rusefi/alphax-8chan/(threads)

Thread 1 (2022-03-19):

Baro LPS22HBTR C94049

rusefillc, 2022-03-19:
can we fit on-board I2C baro LPS22HBTR | C94049

rusefillc, 2022-10-01:
@mck1117 do we have software I2C or do we need hardware I2C?

mck1117, 2022-10-03:
proteus uses bit bang (software) i2c and it works fine enough for baro, so any gpio will work.

rusefillc, 2022-10-20:
@andreika-git please use non-I2C GPIO

andreika-git, 2022-10-23:
Added the baro sensor:

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

Closed 2022-10-23.

Thread 3 (2022-06-28):

analog mux between IAT and CLT, where else?

rusefillc, 2022-06-28:
https://github.com/rusefi/stim is finally a success shall we use same analog mux chip on 8chan for VBatt/CLT/IAT/something else?

actually let's use C91307 2 input/single control bit

IAT/CLT
AT3/AT4
VBAT/xxx?

mck1117, 2022-06-28:
Use the same 2-input muxes as inside the VR-discrete module.

Usable on any channel other than MAP or knock.

rusefillc, 2022-06-28:
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

C87403
NC7SB3157P6X $5 no way

@andreika-git did we substitute on alphax?

mck1117, 2022-06-29:
there are plenty of cheap options like  C91307

https://jlcpcb.com/parts/componentSearch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

rusefillc, 2022-10-01:
#17

ElDominio, 2022-10-01:
I'd say choose some of the last pins in the pinout to be low priority Analog inputs, maybe have the first 10/12 high priority then the rest low priority?

rusefillc, 2022-10-01:
@andreika-git let's mux one of the aux analog inputs with a 3rd single channel mux controller by same AMUX line

rusefillc, 2022-10-03:
@andreika-git let's mux one of aux from #16

andreika-git, 2022-10-05:
Done!
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

rusefillc, 2022-10-05:
@mck1117 :)

mck1117, 2022-10-05:
@andreika-git wait, is that mux BEFORE the analog input filtering stage? That WILL NOT work. It must be muxed as close to the MCU as possible. The analog input filters only have a few hundred hz of bandwidth, so switching between inputs at hundreds of hz will not work.

mck1117, 2022-10-05:
> @mck1117 what's your level of confidence with single control line, multiple 2-input muxes implementation?

100% confident, but the mux does need to be in the correct spot for it to work.

andreika-git, 2022-10-06:
Now mux is between filtered signals closer to mcu:
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

Closed 2022-10-07.

Thread 4 (2022-07-24):

SD card and battery

rusefillc, 2022-07-24:
SD card requirment would mean we are waiting to test a real life https://github.com/rusefi/alphax-4chan/issues/40

rusefillc, 2022-10-01:
4chan rev E has working SD

andreika-git, 2022-10-01:
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

Closed 2022-10-01.

Thread 5 (2022-07-24):

configurable high OR low side aux output, 5A

rusefillc, 2022-07-24:
Can we have a configurable high OR low side 5A output?

rusefillc, 2022-07-30:
would TLE9201 be the best or at least one of the options for high-current configrable push-pull output?

rusefillc, 2022-08-05:
@dron0gus says MC33879 but 0.6A

Qwerty-OFF, 2022-08-05:
MC33887APVW

rusefillc, 2022-08-06:
MC33887APVW looks great!

@dron0gus can you please double-check just to confirm that we can use MC33887APVW as two independent pull/push outputs?

dron0gus, 2022-08-08:
@rusefillc
It is possible to use MC33887APVW as two independent push/pull,
BUT it is not possible to independently switch one output to Hi-Z. Only both at the same time.
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

dron0gus, 2022-08-08:
TLE94112EL is cool. But almost out of stock.

rusefillc, 2022-09-25:
@mck1117 what are your thoughts on MC33887APVW as most flexible push/pull chip?

Closed 2022-10-01.

Thread 6 (2022-07-30):

Physical layout and dimentions

rusefillc, 2022-07-30:
We plan to use our 100% custom CNC case

the only requirent is to have 120 pins of superseal on the same side of the case

Still open question if we will be using 60+60 or 26+34+60 or 60+26+34

great news we have 60 pin footprint already which is 26+34 in single mold of plastic https://github.com/rusefi/kicad6-libraries/commit/ed6bdc60ffba10368ea4b33408f324d4e7dc192b

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

rusefillc, 2022-10-21:
Status update:

J10 stays as 60 pin header like 6437288-3

J11A should be 34 pin 6437288-1
J11B should be 26 pin 6473423-1

Depends on https://github.com/rusefi/kicad6-libraries/issues/1

rusefillc, 2022-11-08:
@andreika-git "J10 stays as 60 pin header like 6437288-3"

i.e. it should be not two (J10+J11) but also not four (J10+J11+J21+J22) but three (60+34+26) if possible

Closed 2022-12-11.

Thread 7 (2022-07-30):

On-board MAP

rusefillc, 2022-07-30:
@eldominio if we fancy a fancy CNC metal case do you see 8chan having on-board MAP sensor or not really?

ElDominio, 2022-07-30:
Yes please, most people need it since they don't know how to connect cables.

rusefillc, 2022-07-30:
"Hex Bulkhead Straight Fitting 2PCS Hose Barb Bulkhead Hex Union Brass Barbed Fitting Connector with 1/4inch Flat Washers"

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

rusefillc, 2022-07-30:
@ElDominio where do you want to place the nipple? would you like the nipple between 60 and 60 or else?

rusefillc, 2022-07-30:
@ElDominio what sensor do you prefer?

there is MPX5700AP which seems to be more suited for brass fitting and hose without turns inside the ECU

rusefillc, 2022-08-03:
Status update:
@ElDominio uses something barbed on 4chan cases already! for now 8chan should use same exact map as 4chan and @ElDominio plans to use same exact barbed fitting and internal hose solution

ElDominio, 2022-08-03:
https://www.ebay.com/itm/252780287663 This is the item i use, and a hose inside the case

rusefillc, 2022-08-04:
let's have a triple-footprint:

to accomodate both sensors soldered directly to PCB (horizontal 2.5 bar and vertical 4bar)

and also a custom 0.1" strip for angled mount. I guess 0.1" strip could actually match 2.5bar pinout?

andreika-git, 2022-10-01:
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

Closed 2022-12-11.

Thread 11 (2022-08-26):

CRANKs/CAMs input hookup points

rusefillc, 2022-08-26:
We need crank/cam test hook up points between signal conditioners and MCU

Worst case rounds surface mounts worst case on the back but through-holes would be nicer

andreika-git, 2022-10-01:
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

Closed 2022-10-01.

Thread 12 (2022-09-25):

MAP/MAF & PPS1/PPS2 clarification

rusefillc, 2022-09-25:
We have

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

Where are MAP/MAF & PPS1/PPS2?

ElDominio, 2022-09-25:
None of them are dedicated? All can be used tofr those functions

rusefillc, 2022-09-25:
@ElDominio question about your exact ford motor

rusefillc, 2022-09-25:
At the moment we can only do 80% of thunder. We need to make sure our 80% fits your harness

andreika-git, 2022-10-03:
Currently the following pinout is used:
- PPS1 = pin A33
- PPS2 = pin A14
- MAP1 = pin A22
- MAP2 is used for internal MAP sensor

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

rusefillc, 2022-10-20:
@ElDominio confirm that you plan to repin current harness since we have no data on existing harness

ElDominio, 2022-10-20:
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
 APS = PPS

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

DI just in case

andreika-git, 2022-10-23:
MAP1 is now on A22
PPS1 = A17
PPS2 = C31

Closed 2022-10-23.

Thread 13 (2022-09-27):

DC motor/pull/push TLE9201 proposal

rusefillc, 2022-09-27:
TLE9201 has benefit of availability, known for us part and much cheaper than MC33887APVW as described at https://github.com/rusefi/alphax-8chan/issues/5#issuecomment-1257261740

What can we accomplish if we use four of TLE9201?
I am assuming that each TLE9201 could be one of three usages for us
* legit DC-motor
* two low side channels
* one high side channel, second channel would need to be ununsed if one channel used for high side

If my abovestated assumption is correct it looks like four of TLE9201 is very promising:
"average" user can do dual ETB and two high side channels (one per TLE9201)
most demanding users can do four ETBs
also possible one ETB and three high sides

overall looks like a pretty good set of functionality as long as i understand TLE9201 possibilities correctly

andreika-git, 2022-10-03:
Now we are using 4 H-bridges:
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

1) C18+C26 = ETB
2) D20+D21 = DC motor
3) A26+A28 = low/high side "hybrid" outputs (dependent)
4) A27+A29 = low/high side "hybrid" outputs (dependent)
  * A26 and A27 correspond to different H-bridge chips because they are connected for IMRC1 and IMRC2.

Currently TLE9201 are used for all 4 chips.

rusefillc, 2022-10-03:
what is IMRC1 ?

also need to move the knowledge to wiki or ideally .pdf

ElDominio, 2022-10-04:
IMRC = Intake Manifold Runner Control, Coyotes have two solenoids (not unlike boost solenoids)  that control some flappers in the intake manifold

rusefillc, 2022-10-05:
@ElDominio please clarify if low side or high side

ElDominio, 2022-10-05:
low side

rusefillc, 2022-10-05:
@andreika-git since low side let's make A26+A27 and A28+A29 pairs to make it a little less confusing

andreika-git, 2022-10-08:
Done!
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

rusefillc, 2023-01-22:
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

Closed 2022-10-08.

Thread 15 (2022-09-30):

VND7 not VND14NV04-E

rusefillc, 2022-09-30:
@ElDominio please approve VND7 for aux low side outputs to stay real and to get JLC assembly

ElDominio, 2022-09-30:
Only for low side correct? Injectors still VND14? if so that's fine

rusefillc, 2022-10-01:
See also #18

rusefillc, 2022-10-02:
@ElDominio I need help understanding why do we need VND14 for injectors?

Actually the plan was to use SOT223 injector drivers like ZXMS6005SGTA for injectors same as hellen154hyundai or nissan

we would need to revisit if we have desire to support v10 i.e. if we need up to 10 injectors with same MOSFET

but first thing first: why VND14 for injectors?

rusefillc, 2022-10-03:
@ElDominio was confused

got confirmation over phone no need for VND14 anywhere

rusefillc, 2022-10-03:
For 8 injectors we will use the output module as usual

@andreika-git please fix schematics to say VND7 not VND14

andreika-git, 2022-10-05:
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

Closed 2022-10-05.

Thread 16 (2022-09-30):

How many analog inputs do we have?

rusefillc, 2022-09-30:
Looks like we are low on analog inputs?

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

I assume a lot of A/D decisions are consequences of 5 trigger input requirment?

Shall we some of not-input-module pins for trigger input in order to get more analog inputs?

See also https://github.com/andreika-git/hellen-one/issues/155

ElDominio, 2022-09-30:
"shall we some of" what?

I was going to propose, I have heard of the "rolling anlog inputs" that have been proposed (I think one processor pin reads multiple analog inputs?)

Can we then have high/low priority input pins? For example, CLT/IAT is know to not read TOO MANY times per second, so assign that to low priority analog inputs, then critical stuff like wideband/MAP/TPS/fuel pressure/oil pressure have a dedicated analog input pin?

andreika-git, 2022-10-03:
Added 3 more analog inputs:
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
They were placed on C31..33 connector pins:
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

Now we have 14 analog inputs and 14 digital inputs total.

The crank input was moved to the PA10 pin USBID (5V-tolerant):
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

Wakeup input was moved to the PE0 pin (UART8_RX) and changed to 3.3v level:
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

Also mcu144-0.7 revision is now used.

rusefillc, 2022-10-04:
@andreika-git please clarify what MCU has PE0 as WKUP or how would wake up work overall? I see only PA0 for 407 and 427?

andreika-git, 2022-10-05:
The WKUP pin is on PA0:
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

Currently we still have +4 free analog inputs (2 muxed), because 2STEP is now on PE0:
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

Thread 18 (2022-09-30):

Can there be two outputs that can also send 5V out? IGN9 IGN10 not rev A

ElDominio, 2022-09-30:
I'd like to have it be 10 channel-capable IF POSSIBLE, if this complicates things too much it's fine to not have it. I'm thinking in the next year or two a V10 might show up for one, but not sure. If it is too difficult we can make something else for that market later

rusefillc, 2022-10-01:
@ElDominio please propose pin numbers

ElDominio, 2022-10-01:
Are we still using Thunder pinout names? if so use 15-16?

rusefillc, 2022-10-03:
Connector D pin 18
Connector D pin 19

Qwerty-OFF, 2023-07-20:
@rusefillc время пришло?

ElDominio, 2023-07-21:
These requests are old

Closed 2023-07-21.

Thread 19 (2022-10-04):

sleep mode current consumption

rusefillc, 2022-10-04:
what can we do for proper low current sleep mode?

rusefillc, 2022-10-04:
See also https://github.com/rusefi/alphax-4chan/issues/65

andreika-git, 2022-10-08:
1. Added a switchable 5V digital power supply:

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

2. Added a switchable 5V analog power supply (based on TLS115):

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

3. Changed some consumers to use switchable power:
- sd-card (3.3v)
- internal map sensor (5va)
- 2 knock modules (5va)
- 3 muxes (5va)
- 2 discrete-vr modules (5v)
- some leds (5v)

rusefillc, 2022-10-20:
@andreika-git are you ready to apply label:"schematics: DONE"?

rusefillc, 2022-11-30:
@Qwerty-OFF please review

andreika-git, 2022-12-11:
Still need more tests... + Waiting for megamodule

Closed 2022-12-11.

Thread 21 (2022-10-05):

no VVT2 trace feature or bug?

rusefillc, 2022-10-05:
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

andreika-git, 2022-10-06:
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

rusefillc, 2022-10-21:
@andreika-git я нашёл её - она сидит над листом

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

andreika-git, 2022-10-23:
Removed the line, thanks!

Closed 2022-10-23.

Thread 22 (2022-10-05):

What is IN_FLEX

rusefillc, 2022-10-05:
@ElDominio flex sensor input is it always digital or is it sometimes analog?

rusefillc, 2022-10-05:
https://github.com/andreika-git/hellen-one/issues/155

ElDominio, 2022-10-05:
Even though it is sometimes analog, if I read "IN_FLEX" I automatically assume it is a digital input. Anyone that wants to use an analog (puke) flex sensor should use a low speed Analog In

rusefillc, 2022-10-05:
For 8chan Flex is digital only

andreika-git, 2022-10-08:
This issue is dependent on https://github.com/andreika-git/hellen-one/issues/171
Currently we have no more free pins to move flex input anywhere.

rusefillc, 2022-10-20:
Progress on https://github.com/andreika-git/hellen-one/issues/171 we have free pins now!

andreika-git, 2022-10-23:
Moved IN_FLEX and CAM_HALL to separate digital input stages:

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

Moved FLEX to another digital pin:

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

Which allowed to add two more analog inputs (muxed)!

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

Closed 2022-10-23.

Thread 23 (2022-10-20):

That vr-discrete analog output shall we wire it

rusefillc, 2022-10-20:
@mck1117 any hints/tricks on where to route vr-discrete analog output? adc3 or normal ADC input? muxed or not muxed?

mck1117, 2022-10-20:
adc3 non-muxed, same rules as knock input

andreika-git, 2022-10-23:
Currently VR analog outputs already use ADC3 non-muxed inputs (ADC3_6 and ADC3_8):
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

Closed 2022-10-23.

Thread 24 (2022-10-23):

Schematics is DONE need review

rusefillc, 2022-10-23:
This https://github.com/rusefi/alphax-8chan is now SCHEMATICS DONE

rusefillc, 2022-10-23:
@Qwerty-OFF can you please review?

@mck1117 can you please review?

mck1117, 2022-10-23:
Add a 1n cap from the input and after the resistor to ground for the digital inputs. Better noise suppression.

Add here (and to others):

Add from `IN_CAM_HALL` and pin 3 to ground (same to all channels).

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

Proteus for reference:

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

mck1117, 2022-10-23:
Connect LED to processed input, not raw input for `IN_CAM_HALL` (others seem to already do this, but not cam??)

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

mck1117, 2022-10-23:
Inconsistent muxed analog naming:

It's confusing that some mux [AT1, AT3] -> `IAT`, but others mux to a net called `AN3_4`. The net should not be called `IAT`, because it isn't IAT.

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

rusefillc, 2022-10-23:
@mck1117 let's create separate tickets like https://github.com/rusefi/alphax-8chan/issues/25?

andreika-git, 2022-10-25:
#25, #28 and #29 done.

rusefillc, 2022-11-30:
@mck1117 we now have PCB, could be 48 to placing the order

rusefillc, 2022-12-11:
@mck1117
@dron0gus
@Qwerty-OFF

Let's have the last round of review?

Closed 2022-12-17.

Thread 26 (2022-10-23):

J11A should be 6437288-2

rusefillc, 2022-10-23:
current J11A should become just J11 and use https://www.te.com/usa-en/product-6437288-2.html

Depends on https://github.com/rusefi/kicad6-libraries/issues/1

rusefillc, 2022-11-23:
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

Closed 2022-11-23.

Thread 27 (2022-10-23):

J11B should be 6473423-2

rusefillc, 2022-10-23:
J11B should become it's own J12

https://www.te.com/usa-en/product-6473423-2.html

rusefillc, 2022-10-23:
Depends on https://github.com/rusefi/kicad6-libraries/issues/1

rusefillc, 2022-11-23:
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

Closed 2022-11-23.

Thread 28 (2022-10-23):

digital inputs. Better noise suppression.

rusefillc, 2022-10-23:
See https://github.com/rusefi/alphax-8chan/issues/24#issuecomment-1288176713

andreika-git, 2022-10-25:
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

rusefillc, 2022-10-25:
@Qwerty-OFF are we affected by same on nissan or hyundai?

Qwerty-OFF, 2022-10-26:
@rusefillc Modules do not contain these capacitors

rusefillc, 2022-10-27:
See https://github.com/rusefi/rusefi/pull/4656

mck1117, 2022-10-27:
Long ago when I said "copy the proteus digital input stages", I did really mean _exactly copy them_. They're the most bulletproof ones we've used so far.

Closed 2022-10-25.

Thread 29 (2022-10-23):

Connect LED to processed input, not raw input for IN_CAM_HALL

rusefillc, 2022-10-23:
See https://github.com/rusefi/alphax-8chan/issues/24#issuecomment-1288177102

andreika-git, 2022-10-25:
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

Closed 2022-10-25.

Thread 30 (2022-10-26):

0603-4 or x4 0402?

rusefillc, 2022-10-26:
https://github.com/rusefi/alphax-4chan/issues/71 freaks me out regarding R0603-4 availability

also I hear those are not easy to hand-solder if repairs are needed

@andreika-git @mck1117 @Qwerty-OFF @dron0gus what are the pros and cons between 0603-4 array versus four single 0201 components?

Qwerty-OFF, 2022-10-26:
0201 almost impossible to hand-solder. Four 0402 is the preferred option. Also, JLC seems to have a lot of C425239
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

mck1117, 2022-10-26:
yeah, please do not use 0201, I'm not even sure JLC will reliably mount those.

0402 is plenty reliable, proteus uses a million of em

rusefillc, 2022-10-26:
It was a typo, I was thinking 4x0402

rusefillc, 2022-10-26:
@Qwerty-OFF @mck1117 @andreika-git what about 0x4 0402?

Closed 2022-11-30.

Thread 31 (2022-10-28):

KiCad footprint for 8chan adapter boards

rusefillc, 2022-10-28:
@ElDominio is asking us to develop some 8chan adapter boards same as we did with Proteus or maybe combined with proteus

ElDominio, 2022-10-29:
Maybe yes maybe no, needs further discussion

Closed 2023-07-21.

Thread 33 (2022-11-23):

ONBOARD_MAP double use?

andreika-git, 2022-11-23:
Currently we have two internal MAP sensors on the same analog line:

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

One is BARO sensor (as in 4chan), and another one is double footprint MAP (MPX***).
Do we need both?

rusefillc, 2022-11-23:
We definitely cannot afford two on-board analog MAP sensors

let's remove analog baro. One day later we might add on-board I2C baro but that would be a separate ticket

rusefillc, 2022-11-23:
Now I am confused with the image

Which one is baro? is U3 baro? is U13 baro? what makes something baro?

See also #7

andreika-git, 2022-11-25:
The Baro is U3. Removed, done.
https://github.com/rusefi/alphax-8chan/commit/6ec1681528d9ea567d7daeb456792b08ba04dfb6

andreika-git, 2022-12-11:
The same as 2chan:
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

Closed 2022-12-12.

Thread 34 (2022-11-30):

Let's try double-sided WBO and double-sided VR

rusefillc, 2022-11-30:
Since we have two WBO and two VR modules can we use latest double-sided version for one WBO and one VR?

rusefillc, 2022-11-30:
@andreika-git I am sorry not great timing I should have suggested this some time ago :(

mck1117, 2022-12-01:
do we really want to do this right before fab on rev A, or should it wait for rev B? There will surely be a rev B.

rusefillc, 2022-12-01:
@mck1117 there are six changes currently in the works
8chan "ready"
new WBO ready
new VR ready
megamodule _soon_
new power supply module _soon_
new knock _soon_

rev A is a prototype anyway. Since rev A is already a prototype I think it's best to add two more small risks into it.

ElDominio, 2022-12-01:
I said OK to WBO and VR since they are not "mission critical" and i'm getting maybe 1 since 4 will probably be spared around for testing

rusefillc, 2022-12-01:
actually https://github.com/andreika-git/hellen-one/tree/master/modules/knock/0.2 we also have already

mck1117, 2022-12-01:
is there a changelog for modules? what's new in knock 2?

rusefillc, 2022-12-01:
@mck1117 https://github.com/andreika-git/hellen-one/blob/master/CHANGELOG.md

Thread 35 (2022-12-01):

tle9201 not rendered on ibom [now not selectable by mouse cursor for some reason]

rusefillc, 2022-12-01:
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

rusefillc, 2022-12-09:
Seems to still be an issue, is this easy or not?

battery seems to be another broken one, what is the level of effort?

rusefillc, 2023-02-01:
@Qwerty-OFF says in relation to ANOTHER board, not sure if relevant or not

"названия у футпринта в хелленне и кикаде разные. Название футпринта в кикаде поменялось когда я в него железно прикрутил большие дырки для пайки"

andreika-git, 2023-02-13:
The problem is in the definition of Infineon_PG-DSO-12-11.kicad_mod. It used a newer Kicad multiline format instead of older one-line format. I've updated the Hellen-One scripts to understand the new format.

Closed 2023-02-13.

Thread 37 (2022-12-01):

Let's use VND10N06TR-E

rusefillc, 2022-12-01:
Q6,Q7,Q8,Q9,Q22,Q23,Q26,Q28,Q29,Q30 let's mention  VND10N06TR-E on the schematics for extra transparency

BOM should be C2149912

Qwerty-OFF, 2022-12-17:
Done

Closed 2022-12-17.

Thread 39 (2022-12-01):

VR only positive

rusefillc, 2022-12-01:
То что от VR на разъем уходят только положительные линии, а негативные заземлены так и задумано?

andreika-git, 2022-12-06:
Насколько я знаю, на этом разъёме не предусмотрены отрицательные линии для VR-сенсоров, а вместо этого сенсор подключается вторым концом на аналоговую землю. На случай, если кому-нибудь понадобится изменить это, предусмотрены джамперы R112 и R113.

Closed 2022-12-06.

Thread 40 (2022-12-01):

Q5 high voltage

rusefillc, 2022-12-01:
Q5 не станет плохо если на IN_CRANK+ будет висеть VR-сенсор с гигантским напряжением?

andreika-git, 2022-12-06:
Да, есть такая опасность... Есть ли идеи, как это улучшить?

andreika-git, 2022-12-08:
Added protection diodes:
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

Closed 2022-12-08.

Thread 43 (2022-12-01):

TACH и MAIN LEDs

rusefillc, 2022-12-01:
Я не понимаю как будут гореть светодиоды TACH и MAIN если у них последовательно стоит 1N4148 в противоположном направлении. Может он должен смотреть туда же куда и светодиод, тогда за счет его большого обратного напряжения со светодиодом ничего не случится?

andreika-git, 2022-12-08:
Done!
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

Closed 2022-12-08.

Thread 45 (2022-12-11):

Yaml

rusefillc, 2022-12-11:
yaml progress in https://github.com/rusefi/rusefi/tree/master/firmware/config/boards/hellen/alphax-8chan/connectors folder is needed

https://rusefi.com/docs/pinouts/hellen/alphax-8chan/ would be the result

andreika-git, 2023-02-15:
@rusefillc Do we use "normal" or "inverted" pin numbers? For example, is CAN2+ on pin D22 (as in the schematics) or D3 as in the current yaml file?

rusefillc, 2023-02-15:
@andreika-git we keep 99% of copper/traves (unless changes due to fixes)

I do not remember if pinout was already flipped or not but we fix yaml and PDF to match copper gerber

Closed 2023-02-17.

Thread 49 (2022-12-13):

VND10N06TR-E direct drive with stm32

rusefillc, 2022-12-13:
See https://github.com/andreika-git/hellen-one/issues/236

How is VND10 in this regard?

rusefillc, 2022-12-13:
@Qwerty-OFF says VND10 has the similar curve

mck1117, 2022-12-13:
exact PN?

rusefillc, 2022-12-13:
@Qwerty-OFF stm32 is allowed to output 2.9v?

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

rusefillc, 2022-12-13:
> exact PN?

VND10N06TR-E

mck1117, 2022-12-13:
I think VND10xxxx will require 5v drive.

> stm32 is allowed to output 2.9v?

You've read that slightly wrong, `vdd - 0.4` is for supply voltage to the stm32 between 2-2.7 volts. If you're sourcing 20mA with a supply voltage of 2.7-3.6v, it could be as low as `vdd - 1.3`, or in our case, 2.0 volts. BUT - that's when sourcing 20mA, which we aren't trying to do. With the current 4.7k pulldown, it's only 0.7mA, so you'll see very near the full 3.3v.

Qwerty-OFF, 2022-12-17:
Fixed
https://github.com/rusefi/alphax-8chan/issues/52#issuecomment-1356315494

Closed 2022-12-17.

Thread 52 (2022-12-14):

VND7xxxxx need series resistor Rin

mck1117, 2022-12-14:
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

ST requires minimum of 150 ohms, or overvoltage and latchup protection may not work:

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

Qwerty-OFF, 2022-12-17:
IGN module contains a level converter and a series resistor.
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

Closed 2022-12-17.

Thread 53 (2022-12-15):

Duplicated designators

Qwerty-OFF, 2022-12-15:
В проекте есть элементы с порядковым номером больше 100, обозначения дублируются с элементами внутри модулей. Нужно переименовать компоненты чтоб попали в неиспользуемый диапазон.

rusefillc, 2022-12-15:
Ой, а скрипты не должны ли упасть?!

Qwerty-OFF, 2022-12-15:
Было бы правильно, сейчас это видно у JLC вот так
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

rusefillc, 2022-12-15:
hellen-one validation https://github.com/andreika-git/hellen-one/issues/244

Closed 2022-12-17.

Thread 55 (2023-01-05):

rev A test log

rusefillc, 2023-01-05:
* USB DFU works
* reset button works

rusefillc, 2023-01-05:
https://github.com/rusefi/alphax-8chan/issues/56

rusefillc, 2023-01-05:
* runs from external +12v

rusefillc, 2023-01-05:
* sends out +5v on 32A

rusefillc, 2023-01-07:
* TPS1&2 read sensors
* ETB works!

rusefillc, 2023-01-09:
* SD card works!

rusefillc, 2023-03-11:
Great news @ElDominio has attempted to run a car!

Other news: looks like 23A digital channel has worked while 30A did not work. On first glance yaml looks fine?

@ElDominio reports that both digital input LEDs were blinking as expected

https://rusefi.com/online/view.php?msq=1417&dialog=triggerConfiguration

https://github.com/rusefi/rusefi/issues/5170#issuecomment-1463224207

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

Closed 2023-07-21.

Thread 59 (2023-01-06):

plugs C and D pinout is mirrored

rusefillc, 2023-01-06:
A-B silk and PCB matches pin numbers on the plugs

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

C and D silk and PCB does not match numbers on the plugs

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

rusefillc, 2023-01-06:
issue is somewhere around https://github.com/rusefi/kicad6-libraries/issues/1 https://github.com/rusefi/alphax-8chan/issues/26 https://github.com/rusefi/alphax-8chan/issues/27

andreika-git, 2023-01-09:
С & D:
kicad6-libraries/Connectors.pretty/6437288-2.kicad_mod
kicad6-libraries/Connectors.pretty/6473423-1.kicad_mod

rusefillc, 2023-01-17:
So A&B everything as rendered on https://rusefi.com/docs/pinouts/hellen/alphax-8chan/

AT THE MOMENT C&D is mirrored over center line in relation to https://rusefi.com/docs/pinouts/hellen/alphax-8chan/

pin 10 is pin 18
pin 18 is pin 10
pin 8 is pin 26
pin 26 is pin 8

ElDominio, 2023-01-23:
I vote keep mirrored. Gives me peace of mind, and no need for redesign

Qwerty-OFF, 2023-07-20:
@rusefillc что мне сейчас c этим делать?

Closed 2023-07-20.

Thread 62 (2023-01-13):

rev A: test new compact VR

rusefillc, 2023-01-13:
@mck1117 @ElDominio looking for help with https://github.com/andreika-git/hellen-one/tree/master/modules/vr-discrete/0.2 testing

ElDominio, 2023-01-23:
Question about VR, does CMP-/CKP- go to sensor ground? Or where?

rusefillc, 2023-01-23:
> Question about VR, does CMP-/CKP- go to sensor ground? Or where?

Not unless you connect yourself?

Closed 2023-07-23.

Thread 63 (2023-01-17):

Frequency inputs in plug B all " to be done later"

ElDominio, 2023-01-17:
Not all have to be frequency, some can be simple on/off with a say 10hz refresh rate.
I'd say B14-b19 frequency, B20-b25 10hz on/off digital input

refers to https://docs.google.com/spreadsheets/d/1-h8c47vzwoVt56TxdpPsfDbb4WIOS3K4TfcJ-AowHh8/edit#gid=0

rusefillc, 2023-01-22:
@ElDominio please share more details on what are the actual sensors you are looking to feed into rusEFI

worst case scenario some or _all_ of these would require an additional microcontroller with additional firmware

@mck1117 FYI

ElDominio, 2023-01-23:
assume at least 10x high frequency inputs
-4 vvt
-1 crank
-flex fuel
-4 wheel speeds

then very slow speed switched inputs (5hz is plenty) (can't this be muxed?)
-clutch up
-clutch down
-starter signal
-brake pedal down
-oil pressure switch
-power steering switch
-2x imrc switch
-reverse light switch
about 10x too

what are the DI negatives on the pinout

mck1117, 2023-01-23:
Switch inputs are practically free, add as many as there are pins on the MCU.

Frequency inputs are very much NOT free. Flex is ok since it’s slow. 4 wheel speeds is too much.

rusefillc, 2023-01-30:
"4 wheel speeds" makes me think secondary F4 MCU

ElDominio, 2023-01-30:
How many frequency inputs can we have? At least a ballpark, so 3x crank/cam and 4x VSS is not possible?

Still a lot more switch inputs are good (ac req, power steer cramp, oil press, etc etc

Closed 2023-07-23.

Thread 66 (2023-01-17):

OUT_DC1/2/3 can be used as aux?

ElDominio, 2023-01-17:
Them being called "low side flyback" leads me to believe I can use them all to trigger something with ground at the same time?

Is there any restriction (IE : using DC- as ground trigger only allows DC+ to be used as positive trigger OR cannot be used at all)

rusefillc, 2023-01-22:
Let me start with good news: DC2 and DC3 are totally here to be used as aux outputs, either low side or high side (with some limitation)

More about that at https://github.com/rusefi/alphax-8chan/issues/13

Now other news: I have no idea what would be needed on the software side. @mck1117 any chance you could help with an explanation and/or software if such would be needed? At least the explanation to begin with I guess :)

ElDominio, 2023-07-23:
Idk and with current YAML, i think having these pins dedicated to DC motor control is fine. Being able to be used high/low is a bonus

Closed 2023-07-23.

Thread 67 (2023-01-29):

C&D renumbering: only reload footprint with proper silk

rusefillc, 2023-01-29:
We have https://github.com/rusefi/alphax-8chan/issues/59 issue.

@ElDominio says to keep physical copper on the board as is, i.e. current physical pinout becomes official pinout

As a step towards fixing documentation we shall take correct fresh versions of connector silk from https://github.com/rusefi/kicad6-libraries to get corrected silk while keeping traces as is

rusefillc, 2023-01-29:
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

Closed 2023-01-30.

Thread 68 (2023-01-29):

How does VR work?

ElDominio, 2023-01-29:
Example, Coyote engine has VR on crank and two cams (other cams are Hall), how do I wire it?

rusefillc, 2023-01-30:
I believe it's only two VR on 8chan at the moment

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

ElDominio, 2023-01-30:
I need one more :(

ElDominio, 2023-05-05:
Where do I wire VR-? @rusefillc

rusefillc, 2023-05-05:
@ElDominio Analog Ground https://rusefi.com/docs/pinouts/hellen/alphax-8chan/?pin=24A

ElDominio, 2023-05-05:
[8chanvrcoyote.zip](https://github.com/rusefi/alphax-8chan/files/11410621/8chanvrcoyote.zip)

Is this okay??
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

It might not have worked because I am dumb

Closed 2023-07-23.

Thread 69 (2023-01-30):

C&D renumbering: adjust schematics to match tracing reality

rusefillc, 2023-01-30:
@ElDominio says to accept #59 as new reality

We've made some progress on PCB side under #67

This ticket is about flipping pinout on the schematics. It's expected that between fixed connector component and this fix of schematics most (all with exception of GND? all?) of tracing would stay the same between rev A and rev B.

andreika-git, 2023-02-16:
Done!

Closed 2023-02-16.

Thread 75 (2023-03-11):

what is pin 9A

rusefillc, 2023-03-11:
we need better documentation

We need blue comments on the schematics and better hints in the yaml

Question: 9A is it VR _only_ or configurable?

  - pin: 9A
    function: Cam VR
    # H144_IN_RES1
    id: F9
    class: event_inputs
    ts_name: 9A - Cam VR

andreika-git, 2023-03-11:
9A is VR only

Closed 2023-03-11.

Thread 76 (2023-03-11):

23A is it hall1 or cam_hall or else? very confusing

rusefillc, 2023-03-11:
yaml says hall 1
```
  - pin: 23A
    function: Hall Input 1
    # IN_CAM
    id: A6
    class: event_inputs
    ts_name: 23A - Hall Input 1

```

schematics says IN_CAM_HALL

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

schematics also has HALL1 which seems to be part of configurable something

NEED COMMENTS on the schematics

andreika-git, 2023-03-11:
On the schematics:
HALL1 is a configurable part of IN_CRANK with switchable pull-up.
CAM_HALL is a generic digital input with configurable pull-up/pull-down feature.
HALL2, HALL3, HALL4, FLEX are generic digital inputs with permanent +5V pull-up.

rusefillc, 2023-03-13:
@andreika-git
``HALL1 (8A) is a configurable part of IN_CRANK with switchable pull-up.``

what does this mean? what is configurable between what and what?

Qwerty-OFF, 2023-07-20:
Pulldown/Pullup
@rusefillc should I do something?

Thread 77 (2023-03-11):

Does hall4 not have LED?

rusefillc, 2023-03-11:
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

rusefillc, 2023-03-13:
@ElDominio looks like not having LED helps HALL4 to be not broken :( Please use Hall4 C5

Qwerty-OFF, 2023-07-20:
Added

Closed 2023-07-20.

Thread 79 (2023-03-11):

revB wishlist

ElDominio, 2023-03-11:
For the next revision of 8chan:

-> NEED at least 3x VR input, since Coyote is 3x VR, 2x Hall

-> Smaller board footprint; must it be the size of a science book?

Pin updates:

Connector A
- 6A > 8v output power (have actually been asked for this, since apparently it works with both 5v and 12v hall)
- change name of 17A from PPS1 to something indicating voltage input

Connector B
- 1B > 12v switched output (so like generic outputs but gives 12v instead of gnd, useful for honda vtec)
- 18B to 25B > digital inputs, not necessarily high frequency

Connector C
- 33C/34C > Knock 1 and 2
- BIG CHANGES HERE:
- -move 1C/10C to 7C/8C, ETB +/-
- -10C-13C > injectors 9-12
- -1C-4C > ignition 9-12
- END BIG CHANGES
- 5C/6C > PPS1/2
- 22C-24C > voltage input

Connector D
- 25C/26C > DC4 +/-
- 17D-19D > Low Side outputs
- 20D/22D > High Side Outputs

-> Built in baro onboard, so this menu is used
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

This one? https://jlcpcb.com/partdetail/Goertek-SPL06001/C2684428

ElDominio, 2023-03-15:
Move MAP location nearer to the middle of the board or close to connector, to evade damage during shipping

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

Like so
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

ElDominio, 2023-04-03:
Needs revisiting because some pins are in use

ElDominio, 2023-05-20:
Connector B:
18B to 25B

18B - VR1+
19B - VR1-
20B - VR2+
21B - VR2-
22B - VR3+
23B - VR3-
24B - VR4+
25B - VR4-

ElDominio, 2023-06-07:
`For the next revision of 8chan:

-> NEED at least 3x VR input, since Coyote is 3x VR, 2x Hall #91

-> Smaller board footprint; must it be the size of a science book?

-> Change to USB type B (big ugly printer) https://github.com/rusefi/alphax-8chan/issues/94

Pin updates:

Connector A
- [less important] 6A > 8v output power (have actually been asked for this, since apparently it works with both 5v and 12v hall)
- change name of 17A from PPS1 to something indicating voltage input

Connector B
- 1B > 12v switched output (so like generic outputs but gives 12v instead of gnd, useful for honda vtec) #92
- 18B to 25B > digital inputs slow inputs, for switches https://github.com/rusefi/alphax-8chan/issues/95

Connector C
- ~33C/34C > Knock 1 and 2 already on rev A~

BIG CHANGES HERE:
- -move 1C/10C to 7C/8C, ETB +/-
- -10C-13C > injectors 9-12
- -1C-4C > ignition 9-12
END BIG CHANGES
- 5C/6C > PPS1/2
- 22C-24C > voltage input

Connector D
- 25C/26C > DC4 +/-
- 17D-19D > Low Side outputs
- 20D/22D > High Side Outputs

-> ~Built in baro onboard, so this menu is used megamcu has baro and accelerometer, accelerometer has no driver~

* Default Tacho to 12v, add a removable component to change to 5V`

Quote of OP

Thread 80 (2023-03-11):

VR/Hall all options should be obvious by looking at https://rusefi.com/docs/pinouts/hellen/alphax-8chan/

rusefillc, 2023-03-11:
https://rusefi.com/docs/pinouts/hellen/alphax-8chan/ should be single page to comprehend trigger input electrical options

rusefillc, 2023-03-11:
@andreika-git see above two commits as starting point

rusefillc, 2023-03-21:
new term ``hysteresis``
good that we have that piece of info!

now raises question how shall we document it more properly where? on the schematics or somewhere else?

Thread 81 (2023-03-13):

hall3 LED blinks but counter does not go up

rusefillc, 2023-03-13:

rusefillc, 2023-03-13:
Fun fact Hall4 5c which does not have LED works from software perspective https://github.com/rusefi/alphax-8chan/issues/77

rusefillc, 2023-03-13:
Rumors are same for Hall2?

rusefillc, 2023-03-13:
J17 works good

J17 is 5v when 31A is floating
J17 is 0v when 31A is ground

rusefillc, 2023-03-13:
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

```
  - pin: 31A
    function: Hall Input 3
    # IN_DIG11
    id: E15
    class: event_inputs
    ts_name: 31A - Hall Input 3
```

rusefillc, 2023-03-13:
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

rusefillc, 2023-03-13:
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

rusefillc, 2023-03-13:
Adding R125 has fixes two boards in NJ

@mck1117 FYI since you have a board

@ElDominio your board would need repair https://github.com/rusefi/alphax-8chan/issues/82

ElDominio, 2023-06-15:
R125 does not show in iBom @rusefillc

rusefillc, 2023-06-15:
@ElDominio see also https://github.com/rusefi/alphax-8chan/issues/82#issuecomment-1467066835

Thread 82 (2023-03-13):

8chan needs R125 - fix hall2 and hall3

rusefillc, 2023-03-13:
@ElDominio when it would be good time please plan to ship your 8chan to NJ for R125 to be added, that would restore hall2 and hall3

ElDominio, 2023-03-13:
what is R125 (value?)? I might be able to do that one with good local board repair guy

rusefillc, 2023-03-13:
it's a quad 0602 4.7K resistor array https://www.mouser.com/ProductDetail/652-CAT16-471J4LF

same part as we were messing with on Hyundai but very different location - you might have a spare part from me or you might have ordered at some point

ElDominio, 2023-03-13:
ah fuck that i'd rather send it to you

rusefillc, 2023-03-25:
boards 2 & 3 fixed
@Timbelom please fix board 1

rusefillc, 2023-05-15:
Another relevant minor issue https://github.com/rusefi/alphax-8chan/issues/104

Thread 83 (2023-03-13):

8chan needs R1030 removed

rusefillc, 2023-03-13:
open question what is the risk maybe unprotected 5v sensor outputs while part is installed?

https://github.com/rusefi/alphax-8chan/issues/81#issuecomment-1466799026

rusefillc, 2023-03-25:
boards 2 and 3 fixed
@Timbelom please fix board 1

Closed 2023-03-25.

Thread 85 (2023-03-31):

triple CAN terminator

rusefillc, 2023-03-31:
CAN resistance should be in 60 to 120Ohm range

At the moment 8chan-A has 40Ohm I assume that's three resistors in parallel?

on all rusEFI boards one terminator would be enough. We shall DNP two terminators on 8chan

rusefillc, 2023-03-31:
Well actually I wonder when do we _EVER_ need 120R on hellen-one WBO module?!

rusefillc, 2023-04-01:
would be handled by https://github.com/andreika-git/hellen-one/issues/280

Closed 2023-07-20.

Thread 86 (2023-03-31):

HW FIX: remove 120R from existing 8chan boards

rusefillc, 2023-03-31:
TBD

Thread 87 (2023-03-31):

only one WBO is talking

rusefillc, 2023-03-31:
Context: honda-k boards have new double-sided WBO-0.4 and I do not see CAN bus comms which makes me wonder if we have problems with WBO-0.4. On that honda-k board i can sense heater being warmed up so WBO-0.4 is at least capable of warming up heater.

8chan has two WBO modules - one 0.3 and one 0.4 making 8chan a perfect test ground for 0.4

So far no proof of 0.4 CAN life on any board

i have 8chanA which has two different WBO of two different revisions, both blinking green

We have index=1 traffic (0x192 0x193) but no index=0 traffic

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

rusefillc, 2023-03-31:
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

rusefillc, 2023-03-31:
hellen121nissan is a board with dual 0.3 some data just for reference https://github.com/rusefi/hellen121nissan-issues/issues/29

rusefillc, 2023-03-31:
I've taken firmware from WBO units on nissan board and unified 8chan with nissan

So to reiterate: on Nissan WHO TX traces look very much similar. on 8chan TX traces are much more different

0.3 TX 5ms
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

0.4 TX 5ms
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

rusefillc, 2023-03-31:
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

Closed 2023-07-20.

Thread 91 (2023-04-03):

Need 3x VR input for Coyote engine, 2x Hall

ElDominio, 2023-04-03:
Coyote is
crank VR
Intake both VR
exhaust Hall

Qwerty-OFF, 2023-07-20:
Which connector pins should be used for VR?

ElDominio, 2023-07-23:
Handled by new YAML (4x)

#112

Closed 2023-07-23.

Thread 92 (2023-04-03):

Pin 1B to be high side output

rusefillc, 2023-04-03:
At the moment 1B is low current main relay output

We should detach it from main relay logic and just make it a 2A+ high side output

Qwerty-OFF, 2023-07-19:
Done

Closed 2023-07-19.

Thread 94 (2023-04-03):

Change to USB-C

rusefillc, 2023-04-03:
but really once we have proper case it's Amphenol type B anyway?

i guess anything on the board should match whatever we have on Amphenol on the nice case

ElDominio, 2023-06-15:
I think we should really use USB-C because of standarization and availability of quality cables.

ElDominio, 2023-06-15:
I think we should really use USB-C because of standarization and availability of quality cables.

Qwerty-OFF, 2023-07-19:
Done

Closed 2023-07-19.

Thread 100 (2023-05-12):

CPU hangs if powered by USB

ElDominio, 2023-05-12:
The ECU hangs if i power it through USB. Normal connection procedure is key on, then connect USB cable. Sometimes, this also causes CPU to hang (blue LED does not blink)

If I press reset while USB is connected, the blue LED blinks for a second then dies (and no USB connection on laptop), I MUST disconnect USB, power off the car, power on the car, THEN connect USB to be able to connect.  This still errors out but not nearly as constant as powering ECU through USB, then keying on.

Bad procedure:
1) USB connected
2) (nothing works)

Correct procedure:
1) Apply external 12v and gnd
2) connect USB
3) very low chance of crash (still crashes sometimes)

rusefillc, 2023-05-12:
@ElDominio please reset firmware to defaults - can you reproduce it?
@ElDominio please consider linking a tune

ElDominio, 2023-05-12:
Tune at https://rusefi.com/online/view.php?msq=1469

I reset to defaults, still does the same thing

Thread 105 (2023-05-15):

Hall1 with hall produces ugly sawtooth wave

ElDominio, 2023-05-15:
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

With settings in next comment

ElDominio, 2023-05-15:
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

This is on pin 9A

ElDominio, 2023-07-23:
No longer needed

Closed 2023-07-23.

Thread 106 (2023-05-31):

headers 3D

rusefillc, 2023-05-31:
3D seems to be missing ECU headers which are useful for case design

слева TE 6473423-1 https://www.te.com/usa-en/product-6473423-1.html
посередине 6437288-2
справа 6437288-3

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

rusefillc, 2023-05-31:
@Ringenium первый шаг - положить step в https://github.com/rusefi/kicad6-libraries?

Ringenium, 2023-06-01:
@rusefillc добавил степы

rusefillc, 2023-06-01:
@Ringenium вижу проресс библиотеки https://github.com/rusefi/kicad6-libraries/commit/db562ba9c1676e8cd117dd0bab22ead44a21c2a2

но ещё надо https://github.com/rusefi/alphax-8chan в самой плате как-то помочь? или прямо футпринт нужно связать с 3D?

Ringenium, 2023-06-01:
@rusefillc понял, сегодня поправлю и на плате

Ringenium, 2023-06-03:
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
подгрузил 3D файлы разъемов, но это не панацея и каждому пользователю нужно самому указывать путь к 3D файлу. Либо чтобы каждый раз так не делать, нужно в пути указывать переменные окружения и класть 3D модели в папку с кикадовскими моделями, типо вот так
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

rusefillc, 2023-06-15:
@Qwerty-OFF нужет твой совет

текущая проблема - 3D файлы скопированы

Qwerty-OFF, 2023-06-15:
Кажется работает такая схема:
- библиотека компонентов лежит субмодулем в папке проекта
- в библиотеке компонентов хранятся 3д модели
- в посадочном месте пусть прописан относительно
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

Я [обновил](https://github.com/rusefi/kicad6-libraries/commit/a94ebd3fa1f0d04625b9a04affa1ee210521cff5) библиотеку, проверьте меня

Ringenium, 2023-06-17:
@Qwerty-OFF У меня что-то не сработало(
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

Qwerty-OFF, 2023-06-17:
@Ringenium надо было футпринты обновить в плате, чтобы изменения появились, делал? Я могу вечером сделать если нужно

Qwerty-OFF, 2023-06-19:
Возможно придется обновить кикад, потому что у меня свежий
Проект теперь выглядит вот так:
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
При этом в самом компоненте путь к модели относительный как на моей картинке выше.
@Ringenium убедись что у тебя теперь модельки тоже работают

Ringenium, 2023-06-20:
@Qwerty-OFF  а какая версия у тебя, 6?

Qwerty-OFF, 2023-06-20:
7

Ringenium, 2023-06-20:
@Qwerty-OFF Так можно в 7 работать, проблем с переносимостью проектов не будет?

Qwerty-OFF, 2023-06-20:
@Ringenium переезжать в 7 можно, просто потом в 6 эти проекты не откроются

Qwerty-OFF, 2023-07-19:
Кажется это можно закрыть

Closed 2023-07-19.

Thread 107 (2023-06-13):

What component to remove to ECU does not stay powered with a constant 12V source on an output?

ElDominio, 2023-06-13:
Mustang alternator has a cable that always has 12v, when it is grounded the alternator starts charging. I need an output that can do this without backfeeding the ECU

Basically same as https://github.com/rusefi/alphax-4chan/issues/63

ElDominio, 2023-07-05:
@Qwerty-OFF  @andreika-git  @rusefillc

rusefillc, 2023-07-05:
@ElDominio can you please loudly state what pin are you trying to use?

@ElDominio please clarify if you had a chance to look at 8chan schematics PDF to see corresponding flyback diode.

Overall let's discuss how do we document flyback removal without asking humans every time such removal is desired? Shall we designate some outputs for relays versus some relays (without flyback) for solenoids (with flyback)?

Thread 108 (2023-06-15):

What components needs to be replaced/removed for Hall 30A and 31A?

ElDominio, 2023-06-15:
I get no reading from either. I remember there was a problem with them, but do not remember what components needed changing

Any idea @Qwerty-OFF @mck1117 @andreika-git

rusefillc, 2023-06-15:
https://github.com/rusefi/alphax-8chan/issues/81
https://github.com/rusefi/alphax-8chan/issues/82
https://github.com/rusefi/alphax-8chan/issues/83

Thread 111 (2023-07-19):

Изменения rev-b

Qwerty-OFF, 2023-07-19:
OUT_PWM4 перестал задавать порог для CAM VR
OUT_PWM6 перестал задавать порог для CRANK VR
DIG2 перестал использоваться для аналогового входа CAM VR
DIG3 перестал использоваться для аналогового входа CRANK VR

Thread 112 (2023-07-22):

8chan rev 2 yaml

rusefillc, 2023-07-22:
https://github.com/rusefi/rusefi/blob/master/firmware/config/boards/hellen/alphax-8chan/connectors/8chan-A-B.yaml
https://github.com/rusefi/rusefi/blob/master/firmware/config/boards/hellen/alphax-8chan/connectors/8chan-C.yaml
https://github.com/rusefi/rusefi/blob/master/firmware/config/boards/hellen/alphax-8chan/connectors/8chan-D.yaml

produce https://rusefi.com/docs/pinouts/hellen/alphax-8chan/

We would need to update.

rev A data could be completely disregarded

Qwerty-OFF, 2023-08-01:
C and D look unchanged

ElDominio, 2023-08-01:
I remember adding much nore to C and D, is my yaml merged?

Qwerty-OFF, 2023-08-01:
Please check
**HALL x7:**

- VSS
- HALL1
- HALL2
- HALL3 (PU/PD)
- HALL4 (PU/PD)
- HALL5 (PU/PD)
- FLEX (PU/PD)

**VR x4:**

- VR1 (VR/HALL) MAX9924
- VR2 discrete
- VR3 discrete
- VR4 discrete

**DC motor x5**

**CAN x2**

**SWITCH x4 (PU only, not configurable)**

**WBO x2**

**Analog (PD only, not configurable) x13:**

- PPS1
- PPS2
- TPS1
- TPS2
- AUX x9

**Analog TEMP x4:**

- IAT (PU/PD)
- CLT (PU/PD)
- AUX x2 (PU)

**INJ + IGN x12**

**LS x14:**

- VVT x4 (high-current VND10)
- PUMP_RELAY (low-current)
- FAN_RELAY (low-current)
- MAIN_RELAY (low-current)
- NOS (low-current)
- BOOST (high-current)
- AUX x5 (high-current)

**TACH LS/5V/12V**

**HS x3**

**KNOCK x2**

**VIGN**

ElDominio, 2023-08-01:
Please check
HALL x7:

    VSS (PU/PD)
    HALL1(PU/PD)
    HALL2 (PU/PD)
    HALL3 (PU/PD)
    HALL4 (PU/PD)
    HALL5 (PU/PD)
    FLEX (PU/PD)

VR x4:

    VR1 (VR/HALL) MAX9924
    VR2 discrete
    VR3 discrete
    VR4 discrete

DC motor  **x4**

CAN x2

SWITCH x4 (PU only, not configurable)

WBO x2

Analog (PD only, not configurable) x13:

    PPS1
    PPS2
    TPS1
    TPS2
    AUX x9

Analog TEMP x4:

    IAT (PU/float)
    CLT (PU/float)
    AUX x2 (PU)

INJ + IGN x12

LS x14:

    VVT x4 (high-current VND10)
    PUMP_RELAY (low-current)
    FAN_RELAY (low-current)
    MAIN_RELAY (low-current)
    NOS (low-current)
    BOOST (high-current)
    AUX x5 (high-current)

TACH LS/5V/12V

HS x3

KNOCK x2

VIGN

only noticwed a problem that it should be 4x DC, all else looks fine

Qwerty-OFF, 2023-08-01:
> VSS (PU/PD)
HALL1(PU/PD)
HALL2 (PU/PD)

Should all HALL have switchable pull-up?

> only noticwed a problem that it should be 4x DC, all else looks fine

I see ETB + 4x DC in yaml.

rusefillc, 2023-08-01:
```

  - pin: 7C
    function: ETB positive
    type: etb
    ts_name: 7C - ETB+
    color: purple

  - pin: 8C
    function: ETB negative
    type: etb
    ts_name: 7C - ETB-
    color: purple

  - pin: 26A
    function: DC1 positive
    type: etb
    color: purple

  - pin: 27A
    function: DC1 negative
    type: etb
    color: purple

  - pin: 28A
    function: DC2 positive
    type: etb
    color: purple

  - pin: 29A
    function: DC2 negative
    type: etb
    color: purple

  - pin: 25D
    function: DC4 positive
    type: etb
    color: purple

  - pin: 26D
    function: DC4 negative
    type: etb
    color: purple

  - pin: 1D
    function: DC3 positive
    type: etb
    color: purple

  - pin: 2D
    function: DC3 negative
    type: etb
    color: purple

```

ElDominio, 2023-08-01:
That was a mistake on my part, I will update YAML to remove

And yes, selectable PU/PD on all hall inputs

Thread 113 (2023-07-22):

max992x software controlled VR<>Hall switch

rusefillc, 2023-07-22:
back on Frankenso it was one pull-up solder mod to switch VR input wire into Hall input wire (other VR would turn into floating 2.5v)

Can we have a software-controlled resistor to switch from VR to Hall in order to reuse pins?

Thread 116 (2023-08-13):

HW shortage: VR discrete analog output

rusefillc, 2023-08-13:
@Qwerty-OFF what exactly are we short on?

rusefillc, 2023-08-13:
Worst case we go all MAX992x

Qwerty-OFF, 2023-08-13:
We are missing:
3x ADC for VR analog output
3x PWM for VR threshold setup

rusefillc, 2023-08-13:
At least one ADC would be nice, reminder those are ADC3 pins

Qwerty-OFF, 2023-09-02:
MM176

Closed 2023-09-02.

Thread 117 (2023-08-13):

HW shortage: gpio pins

rusefillc, 2023-08-13:
We are short on gpio to control all the PU/PD

rusefillc, 2023-08-13:
Our options are I2C which would mean additional firmware development, or MM176

Qwerty-OFF, 2023-09-02:
MM176

Closed 2023-09-02.

Thread 119 (2023-09-25):

8chan-B test log

rusefillc, 2023-09-25:
USB power

* makes high pitch not very loud noise
* no devices in device manager
* no "too much current on USB" windows pop-up

probably two blue LEDs on power supply
no LEDs on MCU module
a LOT of LEDs go ON. first moment those are brighter and noise is louder
then red ones get less bright and noise gets less loud

rusefillc, 2023-09-27:
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

rusefillc, 2023-09-28:
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

even with leads cut we get 0.6A and hot MCU corner

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

thirstyone, 2023-09-28:
to me it looks like it's u100, not mcu (which is a CAN transceiver???) (or it's just the IR image is shifted a bit?)

rusefillc, 2023-09-28:
> IR image is shifted a bit?
totally shifted. secondary hot spots are 3v regulator (note it's outside of board) and power supply, like 2-3cm shifter to left.

rusefillc, 2023-10-04:
By the way we still have continuity buzzing between GND and 3v

thirstyone, 2023-10-04:
If I were you, I would have taken the chip off the board - could easily be a shorting inside the chip...

Thread 120 (2023-11-01):

8chan-C full BOM re-order

rusefillc, 2023-11-01:
Y102 | 20MHz | SMD5032 | X503220MSB2GIC11256620MHz 20pF ±10ppm SMD5032-2P Crystals ROHS | 5 | JLCPCB | Extended | $0.00 | 5 shortfall
-- | -- | -- | -- | -- | -- | -- | -- | --
U755,U756,U755_2,U756_2,U755_3,U756_3 |   | NC7SB3157P6X | SOT-363 | NC7SB3157P6XC8740315Ω 1 SPDT(SPDT) SOT-363-6(SC-70-6) Analog Switches / Multiplexers ROHS | 12 | 4 JLCPCB | Extended | $0.7248 | 8 shortfall

rusefillc, 2023-11-06:
ordered

Closed 2023-11-06.

Thread 122 (2023-11-05):

8chan-C-naked no mux on tps2/pps2

rusefillc, 2023-11-05:
mux не работает - tps2 показывает цифры tps1, pps2 показывает цифры pps1

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

мукс настроен на PF2
```
2023-11-05_01_57_08_787: EngineState: pin PE10 ((null)): EN
2023-11-05_01_57_08_790: EngineState: pin PF2 ((null)): ADC Mux
```

тестовая конфигурация
```
			{ "TPS1_1", PULLED_DOWN_RANGE(DOWN_7B, UP_7B, 680'000) },
			{ "TPS1_2", PULLED_DOWN_RANGE(DOWN_9B, UP_9B, 680'000) },
			{ "PPS1", PULLED_DOWN_RANGE(DOWN_10B, UP_10B, 680'000) },
			{ "PPS2", PULLED_DOWN_RANGE(DOWN_11B, UP_11B, 680'000) },
```

результат теста
```
 ***********************************************
 * BAD channel 1 (TPS1_2): voltage 0.529411808 (raw 27) not in range (0.778592832..0.860549952)
 ***********************************************
 ***********************************************
 * BAD channel 3 (PPS2): voltage 0.862745088 (raw 44) not in range (1.004551530..1.110293744)
 ***********************************************
```

rusefillc, 2023-11-05:
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

Closed 2023-11-05.

Thread 123 (2023-11-25):

8chan-C-full test log

rusefillc, 2023-11-25:
we are off by 1.2% 1.0126180587197349531644259411916 so I am raising expected range a bit
```
 ***********************************************
 * BAD channel 0 (TPS1_1): voltage 0.509803936 (raw 26) not in range (0.516236672..0.570577344)
 ***********************************************
```

rusefillc, 2023-11-28:
```
28/45 ls7 GOOD channel 29
               Setting ADDR 13
               sending line=30 value=1
                          Processing BENCH_TEST_EVENT_COUNTERS ID=770000/l=8 0 0 0 0 0 0 0 0
                          Processing BENCH_TEST_RAW_ANALOG_1 ID=770001/l=8 1A 29 2B 34 0 EB EB 66
                          Processing BENCH_TEST_RAW_ANALOG_2 ID=770006/l=8 0 0 0 0 0 0 0 0
                      ADC says HIGH 30@0 2.792v
               sending line=30 value=0
                          Processing BENCH_TEST_EVENT_COUNTERS ID=770000/l=8 0 0 0 0 0 0 0 0
                          Processing BENCH_TEST_RAW_ANALOG_1 ID=770001/l=8 1A 29 2B 34 0 EB EB 66
                          Processing BENCH_TEST_RAW_ANALOG_2 ID=770006/l=8 0 0 0 0 0 0 0 0
                          Processing BENCH_TEST_IO_META_INFO ID=770005/l=8 66 0 23 1D 2 0 0 0
       CAN ECU says: total=35 outputs of which low side=29 also 2 DC
                          Processing BENCH_TEST_BOARD_STATUS ID=770003/l=8 0 D6 0 1 1C 0 63 0
                          Processing BENCH_TEST_BUTTON_COUNTERS ID=770004/l=8 0 0 0 0 0 0 0 0
ERROR! Line 30@1 FAILED! (set 0, received 1 2.284v)
               sending line=30 value=1
                          Processing BENCH_TEST_EVENT_COUNTERS ID=770000/l=8 0 0 0 0 0 0 0 0
                          Processing BENCH_TEST_RAW_ANALOG_1 ID=770001/l=8 1A 29 2B 34 0 EB EB 66
                          Processing BENCH_TEST_RAW_ANALOG_2 ID=770006/l=8 0 0 0 0 0 0 0 0
               sending line=30 value=0
                          Processing BENCH_TEST_EVENT_COUNTERS ID=770000/l=8 0 0 0 0 0 0 0 0
                          Processing BENCH_TEST_RAW_ANALOG_1 ID=770001/l=8 1B 29 2B 34 0 EB EB 65
                          Processing BENCH_TEST_RAW_ANALOG_2 ID=770006/l=8 0 0 0 0 0 0 0 0
ERROR! Line 30@3 FAILED! (set 0, received 1 2.287v)
!!!!!!! BAD channel 30 hs1 !!!!!!!!!!!!!!!
                          Processing BENCH_TEST_EVENT_COUNTERS ID=770000/l=8 0 0 0 0 0 0 0 0
                          Processing BENCH_TEST_RAW_ANALOG_1 ID=770001/l=8 1B 29 2B 34 0 EB EB 65
                          Processing BENCH_TEST_RAW_ANALOG_2 ID=770006/l=8 0 0 0 0 0 0 0 0
                          Processing BENCH_TEST_IO_META_INFO ID=770005/l=8 66 0 23 1D 2 0 0 0
       CAN ECU says: total=35 outputs of which low side=29 also 2 DC
                          Processing BENCH_TEST_BOARD_STATUS ID=770003/l=8 0 D6 0 1 1C 0 63 0
                          Processing BENCH_TEST_BUTTON_COUNTERS ID=770004/l=8 0 0 0 0 0 0 0 0
                          Processing BENCH_TEST_EVENT_COUNTERS ID=770000/l=8 0 0 0 0 0 0 0 0
                          Processing BENCH_TEST_RAW_ANALOG_1 ID=770001/l=8 1B 29 2B 34 0 EB EB 65
                          Processing BENCH_TEST_RAW_ANALOG_2 ID=770006/l=8 0 0 0 0 0 0 0 0
                          Processing BENCH_TEST_EVENT_COUNTERS ID=770000/l=8 0 0 0 0 0 0 0 0
                          Processing BENCH_TEST_RAW_ANALOG_1 ID=770001/l=8 1B 29 2B 34 0 EB EB 65
                          Processing BENCH_TEST_RAW_ANALOG_2 ID=770006/l=8 0 0 0 0 0 0 0 0
                          Processing BENCH_TEST_IO_META_INFO ID=770005/l=8 66 0 23 1D 2 0 0 0
       CAN ECU says: total=35 outputs of which low side=29 also 2 DC
                          Processing BENCH_TEST_BOARD_STATUS ID=770003/l=8 0 D6 0 1 1C 0 63 0
                          Processing BENCH_TEST_BUTTON_COUNTERS ID=770004/l=8 0 0 0 0 0 0 0 0
                          Processing BENCH_TEST_EVENT_COUNTERS ID=770000/l=8 0 0 0 0 0 0 0 0
                          Processing BENCH_TEST_RAW_ANALOG_1 ID=770001/l=8 1A 29 2B 34 0 EB EB 66
                          Processing BENCH_TEST_RAW_ANALOG_2 ID=770006/l=8 0 0 0 0 0 0 0 0
                          Processing BENCH_TEST_EVENT_COUNTERS ID=770000/l=8 0 0 0 0 0 0 0 0
                          Processing BENCH_TEST_RAW_ANALOG_1 ID=770001/l=8 1B 29 2B 34 0 EB EB 66
                          Processing BENCH_TEST_RAW_ANALOG_2 ID=770006/l=8 0 0 0 0 0 0 0 0
                          Processing BENCH_TEST_EVENT_COUNTERS ID=770000/l=8 0 0 0 0 0 0 0 0
                          Processing BENCH_TEST_RAW_ANALOG_1 ID=770001/l=8 1B 29 2B 34 0 EB EB 66
                          Processing BENCH_TEST_RAW_ANALOG_2 ID=770006/l=8 0 0 0 0 0 0 0 0
                          Processing BENCH_TEST_IO_META_INFO ID=770005/l=8 66 0 23 1D 2 0 0 0
       CAN ECU says: total=35 outputs of which low side=29 also 2 DC
                          Processing BENCH_TEST_BOARD_STATUS ID=770003/l=8 0 D6 0 1 1C 0 63 0
                          Processing BENCH_TEST_BUTTON_COUNTERS ID=770004/l=8 0 0 0 0 0 0 0 0
                          Processing BENCH_TEST_EVENT_COUNTERS ID=770000/l=8 0 0 0 0 0 0 0 0
                          Processing BENCH_TEST_RAW_ANALOG_1 ID=770001/l=8 1A 29 2B 34 0 EB EB 66
                          Processing BENCH_TEST_RAW_ANALOG_2 ID=770006/l=8 0 0 0 0 0 0 0 0
                          Processing BENCH_TEST_EVENT_COUNTERS ID=770000/l=8 0 0 0 0 0 0 0 0
                          Processing BENCH_TEST_RAW_ANALOG_1 ID=770001/l=8 1B 29 2B 34 0 EB EB 66
                          Processing BENCH_TEST_RAW_ANALOG_2 ID=770006/l=8 0 0 0 0 0 0 0 0
                          Processing BENCH_TEST_IO_META_INFO ID=770005/l=8 66 0 23 1D 2 0 0 0
       CAN ECU says: total=35 outputs of which low side=29 also 2 DC
                          Processing BENCH_TEST_BOARD_STATUS ID=770003/l=8 0 D6 0 1 1D 0 63 0
                          Processing BENCH_TEST_BUTTON_COUNTERS ID=770004/l=8 0 0 0 0 0 0 0 0
                          Processing BENCH_TEST_EVENT_COUNTERS ID=770000/l=8 0 0 0 0 0 0 0 0
                          Processing BENCH_TEST_RAW_ANALOG_1 ID=770001/l=8 1B 29 2B 34 0 EA EB 66
                          Processing BENCH_TEST_RAW_ANALOG_2 ID=770006/l=8 0 0 0 0 0 0 0 0
                          Processing BENCH_TEST_EVENT_COUNTERS ID=770000/l=8 0 0 0 0 0 0 0 0
                          Processing BENCH_TEST_RAW_ANALOG_1 ID=770001/l=8 1A 29 2B 34 0 EA EB 66
                          Processing BENCH_TEST_RAW_ANALOG_2 ID=770006/l=8 0 0 0 0 0 0 0 0
               Setting ADDR 14
               sending line=31 value=1
                          Processing BENCH_TEST_EVENT_COUNTERS ID=770000/l=8 0 0 0 0 0 0 0 0
                          Processing BENCH_TEST_RAW_ANALOG_1 ID=770001/l=8 1A 29 2B 34 0 EA EB 66
                          Processing BENCH_TEST_RAW_ANALOG_2 ID=770006/l=8 0 0 0 0 0 0 0 0
                          Processing BENCH_TEST_IO_META_INFO ID=770005/l=8 66 0 23 1D 2 0 0 0
       CAN ECU says: total=35 outputs of which low side=29 also 2 DC
                          Processing BENCH_TEST_BOARD_STATUS ID=770003/l=8 0 D6 0 1 1D 0 63 0
                          Processing BENCH_TEST_BUTTON_COUNTERS ID=770004/l=8 0 0 0 0 0 0 0 0
                      ADC says HIGH 31@0 2.790v
               sending line=31 value=0
                          Processing BENCH_TEST_EVENT_COUNTERS ID=770000/l=8 0 0 0 0 0 0 0 0
                          Processing BENCH_TEST_RAW_ANALOG_1 ID=770001/l=8 1B 29 2B 34 0 EA EB 66
                          Processing BENCH_TEST_RAW_ANALOG_2 ID=770006/l=8 0 0 0 0 0 0 0 0
ERROR! Line 31@1 FAILED! (set 0, received 1 2.794v)
               sending line=31 value=1
                          Processing BENCH_TEST_EVENT_COUNTERS ID=770000/l=8 0 0 0 0 0 0 0 0
                          Processing BENCH_TEST_RAW_ANALOG_1 ID=770001/l=8 1A 29 2B 34 0 EA EB 66
                          Processing BENCH_TEST_RAW_ANALOG_2 ID=770006/l=8 0 0 0 0 0 0 0 0
                          Processing BENCH_TEST_IO_META_INFO ID=770005/l=8 66 0 23 1D 2 0 0 0
       CAN ECU says: total=35 outputs of which low side=29 also 2 DC
                          Processing BENCH_TEST_BOARD_STATUS ID=770003/l=8 0 D6 0 1 1D 0 63 0
                          Processing BENCH_TEST_BUTTON_COUNTERS ID=770004/l=8 0 0 0 0 0 0 0 0
               sending line=31 value=0
                          Processing BENCH_TEST_EVENT_COUNTERS ID=770000/l=8 0 0 0 0 0 0 0 0
                          Processing BENCH_TEST_RAW_ANALOG_1 ID=770001/l=8 1A 29 2B 34 0 EA EB 66
                          Processing BENCH_TEST_RAW_ANALOG_2 ID=770006/l=8 0 0 0 0 0 0 0 0
ERROR! Line 31@3 FAILED! (set 0, received 1 2.790v)
!!!!!!! BAD channel 31 hs2 !!!!!!!!!!!!!!!
                          Processing BENCH_TEST_EVENT_COUNTERS ID=770000/l=8 0 0 0 0 0 0 0 0
                          Processing BENCH_TEST_RAW_ANALOG_1 ID=770001/l=8 1A 29 2B 34 0 EA EB 66
                          Processing BENCH_TEST_RAW_ANALOG_2 ID=770006/l=8 0 0 0 0 0 0 0 0
                          Processing BENCH_TEST_EVENT_COUNTERS ID=770000/l=8 0 0 0 0 0 0 0 0
                          Processing BENCH_TEST_RAW_ANALOG_1 ID=770001/l=8 1B 29 2B 34 0 EA EB 66
                          Processing BENCH_TEST_RAW_ANALOG_2 ID=770006/l=8 0 0 0 0 0 0 0 0
                          Processing BENCH_TEST_IO_META_INFO ID=770005/l=8 66 0 23 1D 2 0 0 0
       CAN ECU says: total=35 outputs of which low side=29 also 2 DC
                          Processing BENCH_TEST_BOARD_STATUS ID=770003/l=8 0 D6 0 1 1D 0 63 0
                          Processing BENCH_TEST_BUTTON_COUNTERS ID=770004/l=8 0 0 0 0 0 0 0 0
                          Processing BENCH_TEST_EVENT_COUNTERS ID=770000/l=8 0 0 0 0 0 0 0 0
                          Processing BENCH_TEST_RAW_ANALOG_1 ID=770001/l=8 1B 29 2B 34 0 EB EB 66
                          Processing BENCH_TEST_RAW_ANALOG_2 ID=770006/l=8 0 0 0 0 0 0 0 0
                          Processing BENCH_TEST_EVENT_COUNTERS ID=770000/l=8 0 0 0 0 0 0 0 0
                          Processing BENCH_TEST_RAW_ANALOG_1 ID=770001/l=8 1B 29 2B 34 0 EB EB 66
                          Processing BENCH_TEST_RAW_ANALOG_2 ID=770006/l=8 0 0 0 0 0 0 0 0
                          Processing BENCH_TEST_IO_META_INFO ID=770005/l=8 66 0 23 1D 2 0 0 0
       CAN ECU says: total=35 outputs of which low side=29 also 2 DC
                          Processing BENCH_TEST_BOARD_STATUS ID=770003/l=8 0 D6 0 1 1E 0 63 0
                          Processing BENCH_TEST_BUTTON_COUNTERS ID=770004/l=8 0 0 0 0 0 0 0 0
                          Processing BENCH_TEST_EVENT_COUNTERS ID=770000/l=8 0 0 0 0 0 0 0 0
                          Processing BENCH_TEST_RAW_ANALOG_1 ID=770001/l=8 1A 29 2B 34 0 EB EB 66
                          Processing BENCH_TEST_RAW_ANALOG_2 ID=770006/l=8 0 0 0 0 0 0 0 0
                          Processing BENCH_TEST_EVENT_COUNTERS ID=770000/l=8 0 0 0 0 0 0 0 0
                          Processing BENCH_TEST_RAW_ANALOG_1 ID=770001/l=8 1B 29 2B 34 0 EB EB 66
                          Processing BENCH_TEST_RAW_ANALOG_2 ID=770006/l=8 0 0 0 0 0 0 0 0
                          Processing BENCH_TEST_EVENT_COUNTERS ID=770000/l=8 0 0 0 0 0 0 0 0
                          Processing BENCH_TEST_RAW_ANALOG_1 ID=770001/l=8 1B 29 2B 34 0 EB EB 66
                          Processing BENCH_TEST_RAW_ANALOG_2 ID=770006/l=8 0 0 0 0 0 0 0 0
                          Processing BENCH_TEST_IO_META_INFO ID=770005/l=8 66 0 23 1D 2 0 0 0
       CAN ECU says: total=35 outputs of which low side=29 also 2 DC
                          Processing BENCH_TEST_BOARD_STATUS ID=770003/l=8 0 D6 0 1 1E 0 63 0
                          Processing BENCH_TEST_BUTTON_COUNTERS ID=770004/l=8 0 0 0 0 0 0 0 0
                          Processing BENCH_TEST_EVENT_COUNTERS ID=770000/l=8 0 0 0 0 0 0 0 0
                          Processing BENCH_TEST_RAW_ANALOG_1 ID=770001/l=8 1B 29 2B 34 0 EB EB 66
                          Processing BENCH_TEST_RAW_ANALOG_2 ID=770006/l=8 0 0 0 0 0 0 0 0
                          Processing BENCH_TEST_EVENT_COUNTERS ID=770000/l=8 0 0 0 0 0 0 0 0
                          Processing BENCH_TEST_RAW_ANALOG_1 ID=770001/l=8 1A 29 2B 34 0 EB EB 66
                          Processing BENCH_TEST_RAW_ANALOG_2 ID=770006/l=8 0 0 0 0 0 0 0 0
                          Processing BENCH_TEST_IO_META_INFO ID=770005/l=8 66 0 23 1D 2 0 0 0
       CAN ECU says: total=35 outputs of which low side=29 also 2 DC
                          Processing BENCH_TEST_BOARD_STATUS ID=770003/l=8 0 D6 0 1 1E 0 63 0
                          Processing BENCH_TEST_BUTTON_COUNTERS ID=770004/l=8 0 0 0 0 0 0 0 0
                          Processing BENCH_TEST_EVENT_COUNTERS ID=770000/l=8 0 0 0 0 0 0 0 0
                          Processing BENCH_TEST_RAW_ANALOG_1 ID=770001/l=8 1B 28 2B 34 0 EB EB 66
                          Processing BENCH_TEST_RAW_ANALOG_2 ID=770006/l=8 0 0 0 0 0 0 0 0
               Setting ADDR 15
               sending line=32 value=1
                          Processing BENCH_TEST_EVENT_COUNTERS ID=770000/l=8 0 0 0 0 0 0 0 0
                          Processing BENCH_TEST_RAW_ANALOG_1 ID=770001/l=8 1B 29 2B 34 0 EB EB 66
                          Processing BENCH_TEST_RAW_ANALOG_2 ID=770006/l=8 0 0 0 0 0 0 0 0
                      ADC says HIGH 32@0 2.790v
               sending line=32 value=0
                          Processing BENCH_TEST_EVENT_COUNTERS ID=770000/l=8 0 0 0 0 0 0 0 0
                          Processing BENCH_TEST_RAW_ANALOG_1 ID=770001/l=8 1A 28 2B 34 0 EB EB 66
                          Processing BENCH_TEST_RAW_ANALOG_2 ID=770006/l=8 0 0 0 0 0 0 0 0
                          Processing BENCH_TEST_IO_META_INFO ID=770005/l=8 66 0 23 1D 2 0 0 0
       CAN ECU says: total=35 outputs of which low side=29 also 2 DC
                          Processing BENCH_TEST_BOARD_STATUS ID=770003/l=8 0 D6 0 1 1E 0 63 0
                          Processing BENCH_TEST_BUTTON_COUNTERS ID=770004/l=8 0 0 0 0 0 0 0 0
ERROR! Line 32@1 FAILED! (set 0, received 1 2.793v)

```

rusefillc, 2023-11-28:
``
bench_setpin D12
bench_clearpin D12
``

rusefillc, 2023-11-28:
pull-down custom test code

```
29/45 hs1 GOOD channel 30
               Setting ADDR 14
               isLowSide=0
               sending line=31 value=1
                          Processing BENCH_TEST_EVENT_COUNTERS ID=770000/l=8 0 0 0 0 0 0 0 0
                          Processing BENCH_TEST_RAW_ANALOG_1 ID=770001/l=8 1A 29 2B 34 0 EA EB 66
                          Processing BENCH_TEST_RAW_ANALOG_2 ID=770006/l=8 0 0 0 0 0 0 0 0
                      ADC says LOW 31@0 0.002v
ERROR! Line 31@0 FAILED! (set 1, received 0 0.002v)
               sending line=31 value=0
                          Processing BENCH_TEST_EVENT_COUNTERS ID=770000/l=8 0 0 0 0 0 0 0 0
                          Processing BENCH_TEST_RAW_ANALOG_1 ID=770001/l=8 1B 28 2B 34 0 EA EB 66
                          Processing BENCH_TEST_RAW_ANALOG_2 ID=770006/l=8 0 0 0 0 0 0 0 0
                          Processing BENCH_TEST_IO_META_INFO ID=770005/l=8 66 0 23 1D 2 0 0 0
       CAN ECU says: total=35 outputs of which low side=29 also 2 DC
                          Processing BENCH_TEST_BOARD_STATUS ID=770003/l=8 0 D6 0 0 31 0 63 0
                          Processing BENCH_TEST_BUTTON_COUNTERS ID=770004/l=8 0 0 0 0 0 0 0 0
                      ADC says LOW 31@1 0.002v
               sending line=31 value=1
                          Processing BENCH_TEST_EVENT_COUNTERS ID=770000/l=8 0 0 0 0 0 0 0 0
                          Processing BENCH_TEST_RAW_ANALOG_1 ID=770001/l=8 1A 29 2B 34 0 EA EB 66
                          Processing BENCH_TEST_RAW_ANALOG_2 ID=770006/l=8 0 0 0 0 0 0 0 0
                      ADC says LOW 31@2 0.003v
ERROR! Line 31@2 FAILED! (set 1, received 0 0.003v)
               sending line=31 value=0
                          Processing BENCH_TEST_EVENT_COUNTERS ID=770000/l=8 0 0 0 0 0 0 0 0
                          Processing BENCH_TEST_RAW_ANALOG_1 ID=770001/l=8 1A 29 2B 34 0 EA EB 66
                          Processing BENCH_TEST_RAW_ANALOG_2 ID=770006/l=8 0 0 0 0 0 0 0 0
                      ADC says LOW 31@3 0.002v
!!!!!!! BAD channel 31 hs2 !!!!!!!!!!!!!!!
                          Processing BENCH_TEST_IO_META_INFO ID=770005/l=8 66 0 23 1D 2 0 0 0
       CAN ECU says: total=35 outputs of which low side=29 also 2 DC
                          Processing BENCH_TEST_BOARD_STATUS ID=770003/l=8 0 D6 0 0 31 0 63 0
                          Processing BENCH_TEST_BUTTON_COUNTERS ID=770004/l=8 0 0 0 0 0 0 0 0
                          Processing BENCH_TEST_EVENT_COUNTERS ID=770000/l=8 0 0 0 0 0 0 0 0
                          Processing BENCH_TEST_RAW_ANALOG_1 ID=770001/l=8 1B 29 2B 34 0 EA EB 66
                          Processing BENCH_TEST_RAW_ANALOG_2 ID=770006/l=8 0 0 0 0 0 0 0 0
                          Processing BENCH_TEST_EVENT_COUNTERS ID=770000/l=8 0 0 0 0 0 0 0 0
                          Processing BENCH_TEST_RAW_ANALOG_1 ID=770001/l=8 1B 28 2B 34 0 EA EB 66
                          Processing BENCH_TEST_RAW_ANALOG_2 ID=770006/l=8 0 0 0 0 0 0 0 0
                          Processing BENCH_TEST_EVENT_COUNTERS ID=770000/l=8 0 0 0 0 0 0 0 0
                          Processing BENCH_TEST_RAW_ANALOG_1 ID=770001/l=8 1B 28 2B 34 0 EA EB 66
                          Processing BENCH_TEST_RAW_ANALOG_2 ID=770006/l=8 0 0 0 0 0 0 0 0
                          Processing BENCH_TEST_IO_META_INFO ID=770005/l=8 66 0 23 1D 2 0 0 0
       CAN ECU says: total=35 outputs of which low side=29 also 2 DC
                          Processing BENCH_TEST_BOARD_STATUS ID=770003/l=8 0 D6 0 0 31 0 63 0
                          Processing BENCH_TEST_BUTTON_COUNTERS ID=770004/l=8 0 0 0 0 0 0 0 0
                          Processing BENCH_TEST_EVENT_COUNTERS ID=770000/l=8 0 0 0 0 0 0 0 0
                          Processing BENCH_TEST_RAW_ANALOG_1 ID=770001/l=8 1A 29 2B 34 0 EA EB 66
                          Processing BENCH_TEST_RAW_ANALOG_2 ID=770006/l=8 0 0 0 0 0 0 0 0
                          Processing BENCH_TEST_EVENT_COUNTERS ID=770000/l=8 0 0 0 0 0 0 0 0
                          Processing BENCH_TEST_RAW_ANALOG_1 ID=770001/l=8 1A 29 2B 34 0 EA EB 66
                          Processing BENCH_TEST_RAW_ANALOG_2 ID=770006/l=8 0 0 0 0 0 0 0 0
                          Processing BENCH_TEST_IO_META_INFO ID=770005/l=8 66 0 23 1D 2 0 0 0
       CAN ECU says: total=35 outputs of which low side=29 also 2 DC
                          Processing BENCH_TEST_BOARD_STATUS ID=770003/l=8 0 D6 0 0 31 0 63 0
                          Processing BENCH_TEST_BUTTON_COUNTERS ID=770004/l=8 0 0 0 0 0 0 0 0
                          Processing BENCH_TEST_EVENT_COUNTERS ID=770000/l=8 0 0 0 0 0 0 0 0
                          Processing BENCH_TEST_RAW_ANALOG_1 ID=770001/l=8 1A 29 2B 34 0 EA EB 66
                          Processing BENCH_TEST_RAW_ANALOG_2 ID=770006/l=8 0 0 0 0 0 0 0 0
                          Processing BENCH_TEST_EVENT_COUNTERS ID=770000/l=8 0 0 0 0 0 0 0 0
                          Processing BENCH_TEST_RAW_ANALOG_1 ID=770001/l=8 1A 29 2B 34 0 EA EB 66
                          Processing BENCH_TEST_RAW_ANALOG_2 ID=770006/l=8 0 0 0 0 0 0 0 0
                          Processing BENCH_TEST_EVENT_COUNTERS ID=770000/l=8 0 0 0 0 0 0 0 0
                          Processing BENCH_TEST_RAW_ANALOG_1 ID=770001/l=8 1A 29 2B 34 0 EA EB 66
                          Processing BENCH_TEST_RAW_ANALOG_2 ID=770006/l=8 0 0 0 0 0 0 0 0
                          Processing BENCH_TEST_IO_META_INFO ID=770005/l=8 66 0 23 1D 2 0 0 0
       CAN ECU says: total=35 outputs of which low side=29 also 2 DC
                          Processing BENCH_TEST_BOARD_STATUS ID=770003/l=8 0 D6 0 0 32 0 63 0
                          Processing BENCH_TEST_BUTTON_COUNTERS ID=770004/l=8 0 0 0 0 0 0 0 0
                          Processing BENCH_TEST_EVENT_COUNTERS ID=770000/l=8 0 0 0 0 0 0 0 0
                          Processing BENCH_TEST_RAW_ANALOG_1 ID=770001/l=8 1A 28 2B 34 0 EA EB 66
                          Processing BENCH_TEST_RAW_ANALOG_2 ID=770006/l=8 0 0 0 0 0 0 0 0
                          Processing BENCH_TEST_EVENT_COUNTERS ID=770000/l=8 0 0 0 0 0 0 0 0
                          Processing BENCH_TEST_RAW_ANALOG_1 ID=770001/l=8 1A 28 2B 34 0 EA EB 66
                          Processing BENCH_TEST_RAW_ANALOG_2 ID=770006/l=8 0 0 0 0 0 0 0 0
               Setting ADDR 15
               isLowSide=0
               sending line=32 value=1
                          Processing BENCH_TEST_IO_META_INFO ID=770005/l=8 66 0 23 1D 2 0 0 0
       CAN ECU says: total=35 outputs of which low side=29 also 2 DC
                          Processing BENCH_TEST_BOARD_STATUS ID=770003/l=8 0 D6 0 0 32 0 63 0
                          Processing BENCH_TEST_BUTTON_COUNTERS ID=770004/l=8 0 0 0 0 0 0 0 0
                          Processing BENCH_TEST_EVENT_COUNTERS ID=770000/l=8 0 0 0 0 0 0 0 0
                          Processing BENCH_TEST_RAW_ANALOG_1 ID=770001/l=8 1A 29 2B 34 0 EA EB 66
                          Processing BENCH_TEST_RAW_ANALOG_2 ID=770006/l=8 0 0 0 0 0 0 0 0
                      ADC says LOW 32@0 0.002v
ERROR! Line 32@0 FAILED! (set 1, received 0 0.002v)
               sending line=32 value=0
                          Processing BENCH_TEST_EVENT_COUNTERS ID=770000/l=8 0 0 0 0 0 0 0 0
                          Processing BENCH_TEST_RAW_ANALOG_1 ID=770001/l=8 1A 28 2B 34 0 EA EB 66
                          Processing BENCH_TEST_RAW_ANALOG_2 ID=770006/l=8 0 0 0 0 0 0 0 0
                      ADC says LOW 32@1 0.002v
               sending line=32 value=1
                          Processing BENCH_TEST_EVENT_COUNTERS ID=770000/l=8 0 0 0 0 0 0 0 0
                          Processing BENCH_TEST_RAW_ANALOG_1 ID=770001/l=8 1A 28 2B 34 0 EA EB 66
                          Processing BENCH_TEST_RAW_ANALOG_2 ID=770006/l=8 0 0 0 0 0 0 0 0
                          Processing BENCH_TEST_IO_META_INFO ID=770005/l=8 66 0 23 1D 2 0 0 0
       CAN ECU says: total=35 outputs of which low side=29 also 2 DC
                          Processing BENCH_TEST_BOARD_STATUS ID=770003/l=8 0 D6 0 0 32 0 63 0
                          Processing BENCH_TEST_BUTTON_COUNTERS ID=770004/l=8 0 0 0 0 0 0 0 0
                      ADC says LOW 32@2 0.002v
ERROR! Line 32@2 FAILED! (set 1, received 0 0.002v)
               sending line=32 value=0
                          Processing BENCH_TEST_EVENT_COUNTERS ID=770000/l=8 0 0 0 0 0 0 0 0
                          Processing BENCH_TEST_RAW_ANALOG_1 ID=770001/l=8 1A 29 2B 34 0 EA EB 66
                          Processing BENCH_TEST_RAW_ANALOG_2 ID=770006/l=8 0 0 0 0 0 0 0 0
                      ADC says LOW 32@3 0.003v
!!!!!!! BAD channel 32 hs3 !!!!!!!!!!!!!!!
                          Processing BENCH_TEST_EVENT_COUNTERS ID=770000/l=8 0 0 0 0 0 0 0 0
                          Processing BENCH_TEST_RAW_ANALOG_1 ID=770001/l=8 1A 29 2B 34 0 EA EB 66
                          Processing BENCH_TEST_RAW_ANALOG_2 ID=770006/l=8 0 0 0 0 0 0 0 0
                          Processing BENCH_TEST_IO_META_INFO ID=770005/l=8 66 0 23 1D 2 0 0 0
       CAN ECU says: total=35 outputs of which low side=29 also 2 DC
                          Processing BENCH_TEST_BOARD_STATUS ID=770003/l=8 0 D6 0 0 32 0 63 0
                          Processing BENCH_TEST_BUTTON_COUNTERS ID=770004/l=8 0 0 0 0 0 0 0 0
                          Processing BENCH_TEST_EVENT_COUNTERS ID=770000/l=8 0 0 0 0 0 0 0 0
                          Processing BENCH_TEST_RAW_ANALOG_1 ID=770001/l=8 1A 29 2B 34 0 EA EB 66
                          Processing BENCH_TEST_RAW_ANALOG_2 ID=770006/l=8 0 0 0 0 0 0 0 0
                          Processing BENCH_TEST_EVENT_COUNTERS ID=770000/l=8 0 0 0 0 0 0 0 0
                          Processing BENCH_TEST_RAW_ANALOG_1 ID=770001/l=8 1A 28 2B 34 0 EA EB 66
                          Processing BENCH_TEST_RAW_ANALOG_2 ID=770006/l=8 0 0 0 0 0 0 0 0
                          Processing BENCH_TEST_EVENT_COUNTERS ID=770000/l=8 0 0 0 0 0 0 0 0
                          Processing BENCH_TEST_RAW_ANALOG_1 ID=770001/l=8 1B 29 2B 34 0 EA EB 66
                          Processing BENCH_TEST_RAW_ANALOG_2 ID=770006/l=8 0 0 0 0 0 0 0 0
                          Processing BENCH_TEST_IO_META_INFO ID=770005/l=8 66 0 23 1D 2 0 0 0
       CAN ECU says: total=35 outputs of which low side=29 also 2 DC
                          Processing BENCH_TEST_BOARD_STATUS ID=770003/l=8 0 D6 0 0 33 0 63 0
                          Processing BENCH_TEST_BUTTON_COUNTERS ID=770004/l=8 0 0 0 0 0 0 0 0
                          Processing BENCH_TEST_EVENT_COUNTERS ID=770000/l=8 0 0 0 0 0 0 0 0
                          Processing BENCH_TEST_RAW_ANALOG_1 ID=770001/l=8 1A 29 2B 34 0 EA EB 66
                          Processing BENCH_TEST_RAW_ANALOG_2 ID=770006/l=8 0 0 0 0 0 0 0 0
                          Processing BENCH_TEST_EVENT_COUNTERS ID=770000/l=8 0 0 0 0 0 0 0 0
                          Processing BENCH_TEST_RAW_ANALOG_1 ID=770001/l=8 1A 29 2B 34 0 EA EB 66
                          Processing BENCH_TEST_RAW_ANALOG_2 ID=770006/l=8 0 0 0 0 0 0 0 0
                          Processing BENCH_TEST_IO_META_INFO ID=770005/l=8 66 0 23 1D 2 0 0 0
       CAN ECU says: total=35 outputs of which low side=29 also 2 DC
                          Processing BENCH_TEST_BOARD_STATUS ID=770003/l=8 0 D6 0 0 33 0 63 0
                          Processing BENCH_TEST_BUTTON_COUNTERS ID=770004/l=8 0 0 0 0 0 0 0 0
                          Processing BENCH_TEST_EVENT_COUNTERS ID=770000/l=8 0 0 0 0 0 0 0 0
                          Processing BENCH_TEST_RAW_ANALOG_1 ID=770001/l=8 1A 29 2B 34 0 EA EB 66
                          Processing BENCH_TEST_RAW_ANALOG_2 ID=770006/l=8 0 0 0 0 0 0 0 0
                          Processing BENCH_TEST_EVENT_COUNTERS ID=770000/l=8 0 0 0 0 0 0 0 0
                          Processing BENCH_TEST_RAW_ANALOG_1 ID=770001/l=8 1A 29 2B 34 0 EA EB 66
                          Processing BENCH_TEST_RAW_ANALOG_2 ID=770006/l=8 0 0 0 0 0 0 0 0
                          Processing BENCH_TEST_EVENT_COUNTERS ID=770000/l=8 0 0 0 0 0 0 0 0
                          Processing BENCH_TEST_RAW_ANALOG_1 ID=770001/l=8 1B 28 2B 34 0 EA EB 66
                          Processing BENCH_TEST_RAW_ANALOG_2 ID=770006/l=8 0 0 0 0 0 0 0 0
                          Processing BENCH_TEST_IO_META_INFO ID=770005/l=8 66 0 23 1D 2 0 0 0
       CAN ECU says: total=35 outputs of which low side=29 also 2 DC
                          Processing BENCH_TEST_BOARD_STATUS ID=770003/l=8 0 D6 0 0 33 0 63 0
                          Processing BENCH_TEST_BUTTON_COUNTERS ID=770004/l=8 0 0 0 0 0 0 0 0
                          Processing BENCH_TEST_EVENT_COUNTERS ID=770000/l=8 0 0 0 0 0 0 0 0
                          Processing BENCH_TEST_RAW_ANALOG_1 ID=770001/l=8 1B 29 2B 34 0 EA EB 66
                          Processing BENCH_TEST_RAW_ANALOG_2 ID=770006/l=8 0 0 0 0 0 0 0 0
               Setting ADDR 0
               isLowSide=0
               sending line=33 value=1
                          Processing BENCH_TEST_EVENT_COUNTERS ID=770000/l=8 0 0 0 0 0 0 0 0
                          Processing BENCH_TEST_RAW_ANALOG_1 ID=770001/l=8 1B 29 2B 34 0 EA EB 66
                          Processing BENCH_TEST_RAW_ANALOG_2 ID=770006/l=8 0 0 0 0 0 0 0 0
                      ADC says HIGH 33@0 1.094v
               sending line=33 value=0
                          Processing BENCH_TEST_IO_META_INFO ID=770005/l=8 66 0 23 1D 2 0 0 0
       CAN ECU says: total=35 outputs of which low side=29 also 2 DC
                          Processing BENCH_TEST_BOARD_STATUS ID=770003/l=8 0 D6 0 0 33 0 63 0
                          Processing BENCH_TEST_BUTTON_COUNTERS ID=770004/l=8 0 0 0 0 0 0 0 0
                          Processing BENCH_TEST_EVENT_COUNTERS ID=770000/l=8 0 0 0 0 0 0 0 0
                          Processing BENCH_TEST_RAW_ANALOG_1 ID=770001/l=8 1A 29 2B 34 0 EA EB 65
                          Processing BENCH_TEST_RAW_ANALOG_2 ID=770006/l=8 0 0 0 0 0 0 0 0
                      ADC says LOW 33@1 0.003v
               sending line=33 value=1
                          Processing BENCH_TEST_EVENT_COUNTERS ID=770000/l=8 0 0 0 0 0 0 0 0
                          Processing BENCH_TEST_RAW_ANALOG_1 ID=770001/l=8 1A 29 2B 34 0 EA EB 65
                          Processing BENCH_TEST_RAW_ANALOG_2 ID=770006/l=8 0 0 0 0 0 0 0 0
                      ADC says HIGH 33@2 1.093v
               sending line=33 value=0
                          Processing BENCH_TEST_EVENT_COUNTERS ID=770000/l=8 0 0 0 0 0 0 0 0
                          Processing BENCH_TEST_RAW_ANALOG_1 ID=770001/l=8 1A 29 2B 34 0 EA EB 65
                          Processing BENCH_TEST_RAW_ANALOG_2 ID=770006/l=8 0 0 0 0 0 0 0 0
                          Processing BENCH_TEST_IO_META_INFO ID=770005/l=8 66 0 23 1D 2 0 0 0
       CAN ECU says: total=35 outputs of which low side=29 also 2 DC
                          Processing BENCH_TEST_BOARD_STATUS ID=770003/l=8 0 D6 0 0 34 0 63 0
                          Processing BENCH_TEST_BUTTON_COUNTERS ID=770004/l=8 0 0 0 0 0 0 0 0
                      ADC says LOW 33@3 0.003v
32/45 ing1 GOOD channel 33
               Setting ADDR 1
               isLowSide=0
               sending line=34 value=1
                          Processing BENCH_TEST_EVENT_COUNTERS ID=770000/l=8 0 0 0 0 0 0 0 0
                          Processing BENCH_TEST_RAW_ANALOG_1 ID=770001/l=8 1A 28 2B 34 0 EA EB 65
                          Processing
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

Thread 125 (2023-11-26):

Add additional CANBUS with internal 2pin connector

ElDominio, 2023-11-26:
I think having dual CAN might prove useful in some cases. Adding a 2 pin connector internally would not change pinout and give us that CAN

rusefillc, 2023-11-27:
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

https://rusefi.com/docs/pinouts/hellen/alphax-8chan/?pin=24C

Closed 2023-11-27.

Thread 127 (2023-11-28):

stim fails to validate HS

rusefillc, 2023-11-28:
low side, DC and IGN pins are happily validated

not HS outputs

stim firmware as passing Proteus
```
29/45 hs1 GOOD channel 30
               Setting ADDR 14
               isLowSide=0
               sending line=31 value=1
                          Processing BENCH_TEST_EVENT_COUNTERS ID=770000/l=8 0 0 0 0 0 0 0 0
                          Processing BENCH_TEST_RAW_ANALOG_1 ID=770001/l=8 1A 29 2B 34 0 EA EB 66
                          Processing BENCH_TEST_RAW_ANALOG_2 ID=770006/l=8 0 0 0 0 0 0 0 0
                      ADC says LOW 31@0 0.002v
ERROR! Line 31@0 FAILED! (set 1, received 0 0.002v)
               sending line=31 value=0
                          Processing BENCH_TEST_EVENT_COUNTERS ID=770000/l=8 0 0 0 0 0 0 0 0
                          Processing BENCH_TEST_RAW_ANALOG_1 ID=770001/l=8 1B 28 2B 34 0 EA EB 66
                          Processing BENCH_TEST_RAW_ANALOG_2 ID=770006/l=8 0 0 0 0 0 0 0 0
                          Processing BENCH_TEST_IO_META_INFO ID=770005/l=8 66 0 23 1D 2 0 0 0
       CAN ECU says: total=35 outputs of which low side=29 also 2 DC
                          Processing BENCH_TEST_BOARD_STATUS ID=770003/l=8 0 D6 0 0 31 0 63 0
                          Processing BENCH_TEST_BUTTON_COUNTERS ID=770004/l=8 0 0 0 0 0 0 0 0
                      ADC says LOW 31@1 0.002v
               sending line=31 value=1
                          Processing BENCH_TEST_EVENT_COUNTERS ID=770000/l=8 0 0 0 0 0 0 0 0
                          Processing BENCH_TEST_RAW_ANALOG_1 ID=770001/l=8 1A 29 2B 34 0 EA EB 66
                          Processing BENCH_TEST_RAW_ANALOG_2 ID=770006/l=8 0 0 0 0 0 0 0 0
                      ADC says LOW 31@2 0.003v
ERROR! Line 31@2 FAILED! (set 1, received 0 0.003v)
               sending line=31 value=0
                          Processing BENCH_TEST_EVENT_COUNTERS ID=770000/l=8 0 0 0 0 0 0 0 0
                          Processing BENCH_TEST_RAW_ANALOG_1 ID=770001/l=8 1A 29 2B 34 0 EA EB 66
                          Processing BENCH_TEST_RAW_ANALOG_2 ID=770006/l=8 0 0 0 0 0 0 0 0
                      ADC says LOW 31@3 0.002v
!!!!!!! BAD channel 31 hs2 !!!!!!!!!!!!!!!
                          Processing BENCH_TEST_IO_META_INFO ID=770005/l=8 66 0 23 1D 2 0 0 0
       CAN ECU says: total=35 outputs of which low side=29 also 2 DC
                          Processing BENCH_TEST_BOARD_STATUS ID=770003/l=8 0 D6 0 0 31 0 63 0
                          Processing BENCH_TEST_BUTTON_COUNTERS ID=770004/l=8 0 0 0 0 0 0 0 0
                          Processing BENCH_TEST_EVENT_COUNTERS ID=770000/l=8 0 0 0 0 0 0 0 0
                          Processing BENCH_TEST_RAW_ANALOG_1 ID=770001/l=8 1B 29 2B 34 0 EA EB 66
                          Processing BENCH_TEST_RAW_ANALOG_2 ID=770006/l=8 0 0 0 0 0 0 0 0
                          Processing BENCH_TEST_EVENT_COUNTERS ID=770000/l=8 0 0 0 0 0 0 0 0
                          Processing BENCH_TEST_RAW_ANALOG_1 ID=770001/l=8 1B 28 2B 34 0 EA EB 66
                          Processing BENCH_TEST_RAW_ANALOG_2 ID=770006/l=8 0 0 0 0 0 0 0 0
                          Processing BENCH_TEST_EVENT_COUNTERS ID=770000/l=8 0 0 0 0 0 0 0 0
                          Processing BENCH_TEST_RAW_ANALOG_1 ID=770001/l=8 1B 28 2B 34 0 EA EB 66
                          Processing BENCH_TEST_RAW_ANALOG_2 ID=770006/l=8 0 0 0 0 0 0 0 0
                          Processing BENCH_TEST_IO_META_INFO ID=770005/l=8 66 0 23 1D 2 0 0 0
       CAN ECU says: total=35 outputs of which low side=29 also 2 DC
                          Processing BENCH_TEST_BOARD_STATUS ID=770003/l=8 0 D6 0 0 31 0 63 0
                          Processing BENCH_TEST_BUTTON_COUNTERS ID=770004/l=8 0 0 0 0 0 0 0 0
                          Processing BENCH_TEST_EVENT_COUNTERS ID=770000/l=8 0 0 0 0 0 0 0 0
                          Processing BENCH_TEST_RAW_ANALOG_1 ID=770001/l=8 1A 29 2B 34 0 EA EB 66
                          Processing BENCH_TEST_RAW_ANALOG_2 ID=770006/l=8 0 0 0 0 0 0 0 0
                          Processing BENCH_TEST_EVENT_COUNTERS ID=770000/l=8 0 0 0 0 0 0 0 0
                          Processing BENCH_TEST_RAW_ANALOG_1 ID=770001/l=8 1A 29 2B 34 0 EA EB 66
                          Processing BENCH_TEST_RAW_ANALOG_2 ID=770006/l=8 0 0 0 0 0 0 0 0
                          Processing BENCH_TEST_IO_META_INFO ID=770005/l=8 66 0 23 1D 2 0 0 0
       CAN ECU says: total=35 outputs of which low side=29 also 2 DC
                          Processing BENCH_TEST_BOARD_STATUS ID=770003/l=8 0 D6 0 0 31 0 63 0
                          Processing BENCH_TEST_BUTTON_COUNTERS ID=770004/l=8 0 0 0 0 0 0 0 0
                          Processing BENCH_TEST_EVENT_COUNTERS ID=770000/l=8 0 0 0 0 0 0 0 0
                          Processing BENCH_TEST_RAW_ANALOG_1 ID=770001/l=8 1A 29 2B 34 0 EA EB 66
                          Processing BENCH_TEST_RAW_ANALOG_2 ID=770006/l=8 0 0 0 0 0 0 0 0
                          Processing BENCH_TEST_EVENT_COUNTERS ID=770000/l=8 0 0 0 0 0 0 0 0
                          Processing BENCH_TEST_RAW_ANALOG_1 ID=770001/l=8 1A 29 2B 34 0 EA EB 66
                          Processing BENCH_TEST_RAW_ANALOG_2 ID=770006/l=8 0 0 0 0 0 0 0 0
                          Processing BENCH_TEST_EVENT_COUNTERS ID=770000/l=8 0 0 0 0 0 0 0 0
                          Processing BENCH_TEST_RAW_ANALOG_1 ID=770001/l=8 1A 29 2B 34 0 EA EB 66
                          Processing BENCH_TEST_RAW_ANALOG_2 ID=770006/l=8 0 0 0 0 0 0 0 0
                          Processing BENCH_TEST_IO_META_INFO ID=770005/l=8 66 0 23 1D 2 0 0 0
       CAN ECU says: total=35 outputs of which low side=29 also 2 DC
                          Processing BENCH_TEST_BOARD_STATUS ID=770003/l=8 0 D6 0 0 32 0 63 0
                          Processing BENCH_TEST_BUTTON_COUNTERS ID=770004/l=8 0 0 0 0 0 0 0 0
                          Processing BENCH_TEST_EVENT_COUNTERS ID=770000/l=8 0 0 0 0 0 0 0 0
                          Processing BENCH_TEST_RAW_ANALOG_1 ID=770001/l=8 1A 28 2B 34 0 EA EB 66
                          Processing BENCH_TEST_RAW_ANALOG_2 ID=770006/l=8 0 0 0 0 0 0 0 0
                          Processing BENCH_TEST_EVENT_COUNTERS ID=770000/l=8 0 0 0 0 0 0 0 0
                          Processing BENCH_TEST_RAW_ANALOG_1 ID=770001/l=8 1A 28 2B 34 0 EA EB 66
                          Processing BENCH_TEST_RAW_ANALOG_2 ID=770006/l=8 0 0 0 0 0 0 0 0
               Setting ADDR 15
               isLowSide=0
               sending line=32 value=1
                          Processing BENCH_TEST_IO_META_INFO ID=770005/l=8 66 0 23 1D 2 0 0 0
       CAN ECU says: total=35 outputs of which low side=29 also 2 DC
                          Processing BENCH_TEST_BOARD_STATUS ID=770003/l=8 0 D6 0 0 32 0 63 0
                          Processing BENCH_TEST_BUTTON_COUNTERS ID=770004/l=8 0 0 0 0 0 0 0 0
                          Processing BENCH_TEST_EVENT_COUNTERS ID=770000/l=8 0 0 0 0 0 0 0 0
                          Processing BENCH_TEST_RAW_ANALOG_1 ID=770001/l=8 1A 29 2B 34 0 EA EB 66
                          Processing BENCH_TEST_RAW_ANALOG_2 ID=770006/l=8 0 0 0 0 0 0 0 0
                      ADC says LOW 32@0 0.002v
ERROR! Line 32@0 FAILED! (set 1, received 0 0.002v)
               sending line=32 value=0
                          Processing BENCH_TEST_EVENT_COUNTERS ID=770000/l=8 0 0 0 0 0 0 0 0
                          Processing BENCH_TEST_RAW_ANALOG_1 ID=770001/l=8 1A 28 2B 34 0 EA EB 66
                          Processing BENCH_TEST_RAW_ANALOG_2 ID=770006/l=8 0 0 0 0 0 0 0 0
                      ADC says LOW 32@1 0.002v
               sending line=32 value=1
                          Processing BENCH_TEST_EVENT_COUNTERS ID=770000/l=8 0 0 0 0 0 0 0 0
                          Processing BENCH_TEST_RAW_ANALOG_1 ID=770001/l=8 1A 28 2B 34 0 EA EB 66
                          Processing BENCH_TEST_RAW_ANALOG_2 ID=770006/l=8 0 0 0 0 0 0 0 0
                          Processing BENCH_TEST_IO_META_INFO ID=770005/l=8 66 0 23 1D 2 0 0 0
       CAN ECU says: total=35 outputs of which low side=29 also 2 DC
                          Processing BENCH_TEST_BOARD_STATUS ID=770003/l=8 0 D6 0 0 32 0 63 0
                          Processing BENCH_TEST_BUTTON_COUNTERS ID=770004/l=8 0 0 0 0 0 0 0 0
                      ADC says LOW 32@2 0.002v
ERROR! Line 32@2 FAILED! (set 1, received 0 0.002v)
               sending line=32 value=0
                          Processing BENCH_TEST_EVENT_COUNTERS ID=770000/l=8 0 0 0 0 0 0 0 0
                          Processing BENCH_TEST_RAW_ANALOG_1 ID=770001/l=8 1A 29 2B 34 0 EA EB 66
                          Processing BENCH_TEST_RAW_ANALOG_2 ID=770006/l=8 0 0 0 0 0 0 0 0
                      ADC says LOW 32@3 0.003v
!!!!!!! BAD channel 32 hs3 !!!!!!!!!!!!!!!
                          Processing BENCH_TEST_EVENT_COUNTERS ID=770000/l=8 0 0 0 0 0 0 0 0
                          Processing BENCH_TEST_RAW_ANALOG_1 ID=770001/l=8 1A 29 2B 34 0 EA EB 66
                          Processing BENCH_TEST_RAW_ANALOG_2 ID=770006/l=8 0 0 0 0 0 0 0 0
                          Processing BENCH_TEST_IO_META_INFO ID=770005/l=8 66 0 23 1D 2 0 0 0
       CAN ECU says: total=35 outputs of which low side=29 also 2 DC
                          Processing BENCH_TEST_BOARD_STATUS ID=770003/l=8 0 D6 0 0 32 0 63 0
                          Processing BENCH_TEST_BUTTON_COUNTERS ID=770004/l=8 0 0 0 0 0 0 0 0
                          Processing BENCH_TEST_EVENT_COUNTERS ID=770000/l=8 0 0 0 0 0 0 0 0
                          Processing BENCH_TEST_RAW_ANALOG_1 ID=770001/l=8 1A 29 2B 34 0 EA EB 66
                          Processing BENCH_TEST_RAW_ANALOG_2 ID=770006/l=8 0 0 0 0 0 0 0 0
                          Processing BENCH_TEST_EVENT_COUNTERS ID=770000/l=8 0 0 0 0 0 0 0 0
                          Processing BENCH_TEST_RAW_ANALOG_1 ID=770001/l=8 1A 28 2B 34 0 EA EB 66
                          Processing BENCH_TEST_RAW_ANALOG_2 ID=770006/l=8 0 0 0 0 0 0 0 0
                          Processing BENCH_TEST_EVENT_COUNTERS ID=770000/l=8 0 0 0 0 0 0 0 0
                          Processing BENCH_TEST_RAW_ANALOG_1 ID=770001/l=8 1B 29 2B 34 0 EA EB 66
                          Processing BENCH_TEST_RAW_ANALOG_2 ID=770006/l=8 0 0 0 0 0 0 0 0
                          Processing BENCH_TEST_IO_META_INFO ID=770005/l=8 66 0 23 1D 2 0 0 0
       CAN ECU says: total=35 outputs of which low side=29 also 2 DC
                          Processing BENCH_TEST_BOARD_STATUS ID=770003/l=8 0 D6 0 0 33 0 63 0
                          Processing BENCH_TEST_BUTTON_COUNTERS ID=770004/l=8 0 0 0 0 0 0 0 0
                          Processing BENCH_TEST_EVENT_COUNTERS ID=770000/l=8 0 0 0 0 0 0 0 0
                          Processing BENCH_TEST_RAW_ANALOG_1 ID=770001/l=8 1A 29 2B 34 0 EA EB 66
                          Processing BENCH_TEST_RAW_ANALOG_2 ID=770006/l=8 0 0 0 0 0 0 0 0
                          Processing BENCH_TEST_EVENT_COUNTERS ID=770000/l=8 0 0 0 0 0 0 0 0
                          Processing BENCH_TEST_RAW_ANALOG_1 ID=770001/l=8 1A 29 2B 34 0 EA EB 66
                          Processing BENCH_TEST_RAW_ANALOG_2 ID=770006/l=8 0 0 0 0 0 0 0 0
                          Processing BENCH_TEST_IO_META_INFO ID=770005/l=8 66 0 23 1D 2 0 0 0
       CAN ECU says: total=35 outputs of which low side=29 also 2 DC
                          Processing BENCH_TEST_BOARD_STATUS ID=770003/l=8 0 D6 0 0 33 0 63 0
                          Processing BENCH_TEST_BUTTON_COUNTERS ID=770004/l=8 0 0 0 0 0 0 0 0
                          Processing BENCH_TEST_EVENT_COUNTERS ID=770000/l=8 0 0 0 0 0 0 0 0
                          Processing BENCH_TEST_RAW_ANALOG_1 ID=770001/l=8 1A 29 2B 34 0 EA EB 66
                          Processing BENCH_TEST_RAW_ANALOG_2 ID=770006/l=8 0 0 0 0 0 0 0 0
                          Processing BENCH_TEST_EVENT_COUNTERS ID=770000/l=8 0 0 0 0 0 0 0 0
                          Processing BENCH_TEST_RAW_ANALOG_1 ID=770001/l=8 1A 29 2B 34 0 EA EB 66
                          Processing BENCH_TEST_RAW_ANALOG_2 ID=770006/l=8 0 0 0 0 0 0 0 0
                          Processing BENCH_TEST_EVENT_COUNTERS ID=770000/l=8 0 0 0 0 0 0 0 0
                          Processing BENCH_TEST_RAW_ANALOG_1 ID=770001/l=8 1B 28 2B 34 0 EA EB 66
                          Processing BENCH_TEST_RAW_ANALOG_2 ID=770006/l=8 0 0 0 0 0 0 0 0
                          Processing BENCH_TEST_IO_META_INFO ID=770005/l=8 66 0 23 1D 2 0 0 0
       CAN ECU says: total=35 outputs of which low side=29 also 2 DC
                          Processing BENCH_TEST_BOARD_STATUS ID=770003/l=8 0 D6 0 0 33 0 63 0
                          Processing BENCH_TEST_BUTTON_COUNTERS ID=770004/l=8 0 0 0 0 0 0 0 0
                          Processing BENCH_TEST_EVENT_COUNTERS ID=770000/l=8 0 0 0 0 0 0 0 0
                          Processing BENCH_TEST_RAW_ANALOG_1 ID=770001/l=8 1B 29 2B 34 0 EA EB 66
                          Processing BENCH_TEST_RAW_ANALOG_2 ID=770006/l=8 0 0 0 0 0 0 0 0
               Setting ADDR 0
               isLowSide=0
               sending line=33 value=1
                          Processing BENCH_TEST_EVENT_COUNTERS ID=770000/l=8 0 0 0 0 0 0 0 0
                          Processing BENCH_TEST_RAW_ANALOG_1 ID=770001/l=8 1B 29 2B 34 0 EA EB 66
                          Processing BENCH_TEST_RAW_ANALOG_2 ID=770006/l=8 0 0 0 0 0 0 0 0
                      ADC says HIGH 33@0 1.094v
               sending line=33 value=0
                          Processing BENCH_TEST_IO_META_INFO ID=770005/l=8 66 0 23 1D 2 0 0 0
       CAN ECU says: total=35 outputs of which low side=29 also 2 DC
                          Processing BENCH_TEST_BOARD_STATUS ID=770003/l=8 0 D6 0 0 33 0 63 0
                          Processing BENCH_TEST_BUTTON_COUNTERS ID=770004/l=8 0 0 0 0 0 0 0 0
                          Processing BENCH_TEST_EVENT_COUNTERS ID=770000/l=8 0 0 0 0 0 0 0 0
                          Processing BENCH_TEST_RAW_ANALOG_1 ID=770001/l=8 1A 29 2B 34 0 EA EB 65
                          Processing BENCH_TEST_RAW_ANALOG_2 ID=770006/l=8 0 0 0 0 0 0 0 0
                      ADC says LOW 33@1 0.003v
               sending line=33 value=1
                          Processing BENCH_TEST_EVENT_COUNTERS ID=770000/l=8 0 0 0 0 0 0 0 0
                          Processing BENCH_TEST_RAW_ANALOG_1 ID=770001/l=8 1A 29 2B 34 0 EA EB 65
                          Processing BENCH_TEST_RAW_ANALOG_2 ID=770006/l=8 0 0 0 0 0 0 0 0
                      ADC says HIGH 33@2 1.093v
               sending line=33 value=0
                          Processing BENCH_TEST_EVENT_COUNTERS ID=770000/l=8 0 0 0 0 0 0 0 0
                          Processing BENCH_TEST_RAW_ANALOG_1 ID=770001/l=8 1A 29 2B 34 0 EA EB 65
                          Processing BENCH_TEST_RAW_ANALOG_2 ID=770006/l=8 0 0 0 0 0 0 0 0
                          Processing BENCH_TEST_IO_META_INFO ID=770005/l=8 66 0 23 1D 2 0 0 0
       CAN ECU says: total=35 outputs of which low side=29 also 2 DC
                          Processing BENCH_TEST_BOARD_STATUS ID=770003/l=8 0 D6 0 0 34 0 63 0
                          Processing BENCH_TEST_BUTTON_COUNTERS ID=770004/l=8 0 0 0 0 0 0 0 0
                      ADC says LOW 33@3 0.003v
32/45 ing1 GOOD channel 33
               Setting ADDR 1
               isLowSide=0
               sending line=34 value=1
                          Processing BENCH_TEST_EVENT_COUNTERS ID=770000/l=8 0 0 0 0 0 0 0 0
                          Processing BENCH_TEST_RAW_ANALOG_1 ID=770001/l=8 1A 28 2B 34 0 EA EB 65
                          Processing BENCH_TEST_RAW_ANALOG_2 ID=770006/l=8 0 0 0 0 0 0 0 0
                      ADC says HIGH 34@0 1.092v
               sending line=34 value=0
                          Processing BENCH_TEST_EVENT_COUNTERS ID=770000/l=8 0 0 0 0 0 0 0 0
                          Processing BENCH_TEST_RAW_ANALOG_1 ID=770001/l=8 1A 29 2B 34 0 EA EB 66
                          Processing BENCH_TEST_RAW_ANALOG_2 ID=770006/l=8 0 0 0 0 0 0 0 0
                      ADC says LOW 34@1 0.003v
               sending line=34 value=1
                          Processing BENCH_TEST_IO_META_INFO ID=770005/l=8 66 0 23 1D 2 0 0 0
       CAN ECU says: total=35 outputs of which low side=29 also 2 DC
                          Processing BENCH_TEST_BOARD_STATUS ID=770003/l=8 0 D6 0 0 34 0 63 0
                          Processing BENCH_TEST_BUTTON_COUNTERS ID=770004/l=8 0 0 0 0 0 0 0 0
                          Processing BENCH_TEST_EVENT_COUNTERS ID=770000/l=8 0 0 0 0 0 0 0 0
                          Processing BENCH_TEST_RAW_ANALOG_1 ID=770001/l=8 1A 29 2B 34 0 EA EB 66
                          Processing BENCH_TEST_RAW_ANALOG_2 ID=770006/l=8 0 0 0 0 0 0 0 0
                      ADC says HIGH 34@2 1.094v
               sending line=34 value=0
                          Processing BENCH_TEST_EVENT_COUNTERS ID=770000/l=8 0 0 0 0 0 0 0 0
                          Processing BENCH_TEST_RAW_ANALOG_1 ID=770001/l=8 1A 29 2B 34 0 EA EB 66
                          Processing BENCH_TEST_RAW_ANALOG_2 ID=770006/l=8 0 0 0 0 0 0 0 0
                      ADC says LOW 34@3 0.003v
33/45 ing3 GOOD channel 34
               Setting ADDR 2
               isLowSide=0
               sending line=35 value=1
                          Processing BENCH_TEST_EVENT_COUNTERS ID=770000/l=8 0 0 0 0 0 0 0 0
                          Processing BENCH_TEST_RAW_ANALOG_1 ID=770001/l=8 1A 28 2B 34 0 EA EB 65
                          Processing BENCH_TEST_RAW_ANALOG_2 ID=770006/l=8 0 0 0 0 0 0 0 0
                          Processing BENCH_TEST_IO_META_INFO ID=770005/l=8 66 0 23 1D 2 0 0 0
       CAN ECU says: total=35 outputs of which low side=29 also 2 DC
                          Processing BENCH_TEST_BOARD_STATUS ID=770003/l=8 0 D6 0 0 34 0 63 0
                          Processing BENCH_TEST_BUTTON_COUNTERS ID=770004/l=8 0 0 0 0 0 0 0 0
                      ADC says HIGH 35@0 1.091v
               sending line=35 value=0
                          Processing BENCH_TEST_EVENT_COUNTERS ID=770000/l=8 0 0 0 0 0 0 0 0
                          Processing BENCH_TEST_RAW_ANALOG_1 ID=770001/l=8 1A 28 2B 34 0 EA EB 66
                          Processing BENCH_TEST_RAW_ANALOG_2 ID=770006/l=8 0 0 0 0 0 0 0 0
                      ADC says LOW 35@1 0.003v
               sending line=35 value=1
                          Processing BENCH_TEST_EVENT_COUNTERS ID=770000/l=8 0 0 0 0 0 0 0 0
                          Processing BENCH_TEST_RAW_ANALOG_1 ID=770001/l=8 1A 29 2B 34 0 EA EB 65
                          Processing BENCH_TEST_RAW_ANALOG_2 ID=770006/l=8 0 0 0 0 0 0 0 0
                      ADC says HIGH 35@2 1.091v
               sending line=35 value=0
                          Processing BENCH_TEST_IO_META_INFO ID=770005/l=8 66 0 23 1D 2 0 0 0
       CAN ECU says: total=35 outputs of which low side=29 also 2 DC
                          Processing BENCH_TEST_BOARD_STATUS ID=770003/l=8 0 D6 0 0 34 0 63 0
                          Processing BENCH_TEST_BUTTON_COUNTERS ID=770004/l=8 0 0 0 0 0 0 0 0
                          Processing BENCH_TEST_EVENT_COUNTERS ID=770000/l=8 0 0 0 0 0 0 0 0
                          Processing BENCH_TEST_RAW_ANALOG_1 ID=770001/l=8 1A 29 2B 34 0 EA EB 66
                          Processing BENCH_TEST_RAW_ANALOG_2 ID=770006/l=8 0 0 0 0 0 0 0 0
                      ADC says LOW 35@3 0.003v
34/45 ing5 GOOD channel 35
```

rusefillc, 2023-11-30:
fixed on stim FW side

Closed 2023-11-30.
